banbatakumi/BLDC/ProgramV4/docs/FOC解説.pdf

## BLDC ベクトル制御 (FOC) の仕組み

ProgramV4 制御ソフトウェア解説

本資料は本プロジェクト (src/bldc/foc.c/h, bldc.c/h) が実装している FOC (Field Oriented Control) の中身を、数式と実装の対応関係込みで説明する。 対象はセンサ付き (エンコーダ 有り) の表面磁石型 (SPM) BLDC モータで、 弱め界磁は行わない (i

∗
d = 0 固定)。

### 1 全体構成

制御は 20 kHz の電流ループを中心に、そこから分周した 1 kHz の外側ループ (速度/位置) を 重ねる二重ループ構成である。

周波数 | 処理 | 内容
20 kHz | 角度観測 | エンコーダ角 → 機械角 θm・角速度 ωˆ (2次PLL)
20 kHz | 電流ループ | 電流計測 → Clarke → Park → 電流 PI → 逆Park
| | → SVPWM
1 kHz | 外側ループ | 速度 PID / 位置 PID → q 軸電流指令 i

∗
| | q

電流ループは PWM (TIM1) に同期した ADC 変換完了割り込みでそのまま駆動されるため、 サンプリング周期は PWM 周期と一致し Ts = 1/20000 s = 50 µs である。

図 1 に制御全体のブロック線図を示す。内側から順に 「電流ループ (実線)」「電気角 θe の供 給 (破線, 2次PLL観測器由来)」 「外側の速度/位置ループ (太線)」の3つのフィードバックが 重なっている。

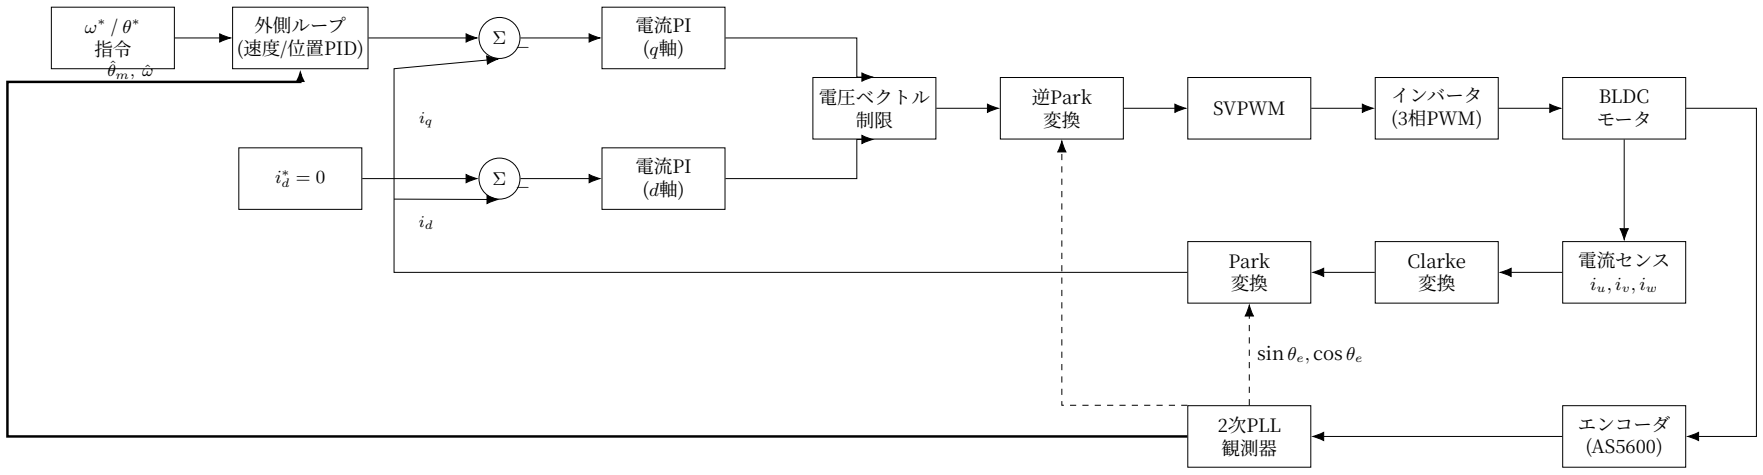
[picture p1: figure]
外側ループ; (速度/位置PID); 電流PI (q軸); 電流PI (d軸); 電圧ベクトル 制限; 逆Park; SVPWM; インバータ (3相PWM); BLDC モータ; 電流センス; Clarke 変換; Park 変換; エンコーダ (AS5600); 2次PLL 観測器; sin θe, cos θe θˆm, ωˆ

図 1: 制御ブロック線図。実線: 電流ループの信号、破線: 2次PLL観測器が供給する 電気角 θe = P ˆθm + θoffset、太線: 速度/位置フィードバック
(ˆθm, ωˆ)。

2

### 2 座標変換

3相電流 iu, iv, iw (iu + iv + iw = 0) を、モータと同期回転する d‑q 座標に移すまでの手順。

### 2.1 Clarke 変換 (振幅一定型)

3相 → 静止2軸 (α, β)。

iα = iu | (1)

iβ =

1
√
3

(iv − iw) = 1
√
3
(iu + 2iv) | (2)

2行目は iw = −(iu + iv) を代入して iv の実測だけで求めたもの（実装では iv − iw ではなくこ の形を使用）。

### 2.2 Park 変換

静止座標 → 回転座標。電気角 θe を使う。

id = iα cos θe + iβ sin θe | (3)
iq = −iα sin θe + iβ cos θe | (4)

電気角は機械角にモータの極対数 P (P = 7) を掛けて作る。

θe = P · θm + θoffset | (5)

θoffset はエンコーダ校正で決める定数で、通常 0 になるように校正する (「電気角の合わせ方」 の節を参照)。

### 2.3 逆 Park 変換

電流 PI の出力電圧 vd, vq を静止座標へ戻す。

vα = vd cos θe − vq sin θe | (6)
vβ = vd sin θe + vq cos θe | (7)

### 3 電流制御

d 軸・q 軸それぞれに独立な PI 制御器を持つ (微分項なし)。

vd = Kp (i

∗
d − id) + Ki

∫
(i

∗
d − id) dt | (8)

vq = Kp (i

∗
q − iq) + Ki

∫
(i

∗
q − iq) dt | (9)

SPM モータなので弱め界磁を行わず i

∗
d = 0 に固定する。トルク電流指令は 外側ループが決め た i

∗
q をそのまま使う。

### 3.1 ゲインの設計

モータの相インダクタンス L、相抵抗 R から、目標帯域 fbw を1次遅れとして 配置するゲイン は次式になる。

Kp = L · 2πfbw | [V/A] | (10)
Ki = R · 2πfbw | [V/(A · s)] | (11)

fbw の上限の目安は PWM 周波数の 1/10 ∼ 1/20 (20 kHz なら 1～2 kHz)。 本プロジェクトの 実装値は Kp = 0.75 V/A, Ki = 750 V/(A·s) (CURRENT_PI_KP / CURRENT_PI_KI)。

### 3.2 電圧ベクトルの円制限とアンチワインドアップ

インバータが出せる相電圧振幅には上限 vmax (母線電圧と変調方式で決まる) があるため、 (vd, vq) のベクトルの大きさをその円内に制限する。

|⃗v| =

√
v

2
d + v
| 2 q | (12)
if |⃗v| > vmax : | vd ← vd ·
| vmax
|⃗v|

, vq ← vq ·

vmax
|⃗v|
| | (13)

制限をかけたときは、そのときの縮小率を積分項にも同じ比率で掛けて縮める。 そうしない と制限中も積分器だけが指令を積み増し続け (ワインドアップ)、 制限が外れた瞬間に電流が 飛び出す。

### 4 SVPWM (空間ベクトル変調)

逆 Clarke 変換で相電圧指令をつくり、3相の最大値と最小値の中点を 全相から引く「min‑max 方式」(三次高調波重畳) でデューティを決める。

vu = vα | (14)

vv = −
1/2 vα +

√
3
2
vβ | (15)

vw = −

1/2 vα −

√
3
2
vβ | (16)

vcom =

1/2(max(vu, vv, vw) + min(vu, vv, vw)) | (17)

dx = 0.5 +

vx − vcom

Vdc

(x = u, v, w) | (18)

単純な正弦波変調に比べ、線間電圧を変えずに相電圧のピークを下げられるため、 母線電圧 の利用率が 2/√
3 ≈ 1.155 倍 (+15%) になる。

本基板はローサイドシャント電流検出のため、ADC サンプリング点で低電位側 FET が ON に なっている必要があり、デューティ上限を MAX_DUTY = 0.80 に制限している。 このとき出せる 相電圧振幅は

(0.80 − 0.5) ×

2
√
3
≈ 0.346 Vdc | (19)

まで（変調方式の理論上限は 0.577 Vdc）。この値が MAX_MODULATION_RATIO であり、 上の vmax = Vdc × MAX_MODULATION_RATIO として電流ループの円制限に使われる。

### 5 角度・速度推定 (2次PLL観測器)

角速度は「角度を微分」せず、推定角 ˆθ を観測角 θmeas に 追従させる制御ループ (2次のオブ ザーバ) として求める。内部状態 ˆθ, ωˆ が角度と速度を同時に与える。

e = θmeas − ˆθ | (イノベーション) | (20)
ωˆ += KI e ∆t | | (21)
ˆθ += (ˆω + KP e) ∆t | (22)

この閉ループの伝達関数は標準的な2次系になる。

Θ( ˆ s)

Θmeas(s)

=

| KP s + KI
s
| 2 + KP s + KI | (23)

固有角周波数と減衰係数は

ωn =

√
KI , ζ =

KP
2

√
KI

(24)

本実装は臨界制動 ζ = 1 を狙い、ωn = PLL_OMEGA_N = 250 rad/s から次のように逆算してゲ インを決めている。

KP = 2 ωn, KI = ω

2
n

(25)

微分ではなく積分で速度を作るため、(1) 量子化ノイズを増幅しない、(2) 等速回転で定常誤差 ゼロ、(3) 観測が一時的に欠測しても ωˆ による外挿で角度を進め続けられる、 という3つの性 質が同時に得られる。

### 5.1 観測値の棄却とゲート

エンコーダ (AS5600 アナログ出力) はレール付近で飽和し、角度が読めない 「盲点」区間を 持つ。信頼できない観測をそのままイノベーション e に使うと 推定が乱れるため、2種類の条 件で棄却する。

(a) 飽和: 生の ADC 値がレール付近 ⇒ 角度情報が無いと確実に分かる。 最大 ENCODER_REJECT_MAX サンプル (50 ms) まで e = 0 として外挿する。

(b) イノベーション過大: |e| が閾値 ENCODER_INNOVATION_LIMIT_RAD を超える。0/2π 継ぎ目の グリッチの可能性があるため、まず ENCODER_GLITCH_MAX サンプル (1 ms) だけ e = 0 とし て様子を見る。 それでも続く場合はグリッチではなく推定が本当にずれた（例:ロータの急 停止）と判断し、 棄却をやめて e を全量 PLL に通し再ロックさせる。

さらに、速度推定 (積分パス) に入れる e は「ロック中のみ」次式のように制限する。

espeed =

{
e | (再取得中)
clip(e, −elim, elim) (ロック中)

(26)

ロック中に残る小さな e は継ぎ目の校正誤差であって本物の回転ではないため、 積分に全量入 れると1回転ごとに速度がスパイクする。逆に再取得中に制限すると dωˆ/dt が頭打ちになり、 急停止からの再ロックができなくなる。

### 5.2 エンコーダのスケール補正

盲点幅を θdead、校正で得た ADC 値の範囲を [ Vmin, Vmax ] とすると、実際にカバーする機械 角は 2π − θdead であるため、 スケールは次式で求める（単純に 2π/(Vmax − Vmin) とすると角 度が引き伸ばされ、 継ぎ目で速度が段差状に跳ぶ）。

kenc =

2π − θdead

Vmax − Vmin

(27)

### 6 外側ループ

1 kHz で動く速度 PID・位置 PID の出力は電圧ではなく電流指令 (q 軸電流 [A]) であり、 その 先の電流ループに渡される。

速度制御: i

∗
q = Kp(ω

∗ − ωˆ) + Ki

∫
(ω
∗ − ωˆ) dt | (28)

位置制御: i

∗
q = Kp(θ

∗ − θm) + Ki

∫
(θ

∗ − θm) dt + Kd

d
dt(θ
∗ − θm) | (29)

速度指令には最大角加速度によるスルーレート制限を、位置制御には目標近傍での 不感帯 (デ ッドバンド) と積分停止を入れて、整定時の余計な電流出力を防いでいる。

### 7 保護

相電流の生値 (フィルタ前) が OVERCURRENT_LIMIT を連続 OVERCURRENT_TRIP_COUNT 回超える と出力を止めてラッチする。 また、停止時 (enable=false) は全相デューティを 0.5 にする短 絡制動ではなく、 上下 FET を両方 OFF にするコースト状態にしている。回転中の全相デュ ーティ 0.5 は 逆起電力による短絡電流

I ≈

E
|R + jωeL|

(30)

を流してしまうため、保護直後に一番電流を流したくない場面で電流が流れる、 という事故 を避けるための設計になっている。

### 8 実装ファイルとの対応

ファイル | 内容
foc.c/h | Clarke / Park / 逆Park / SVPWM / 電流 PI・円制限
| の数学部分
bldc.c/h | 角度追従オブザーバ・外側ループ・電流ループの本
| 体、保護、シリアル用の状態取得 API
current_sense.c/h | PWM 同期のローサイドシャント電流計測
app/config.h | 全パラメータ（本資料の数式中の記号との対応は表
| 中コードで参照）
