banbatakumi/BLDC/CurcuitV4/pcb.dxf

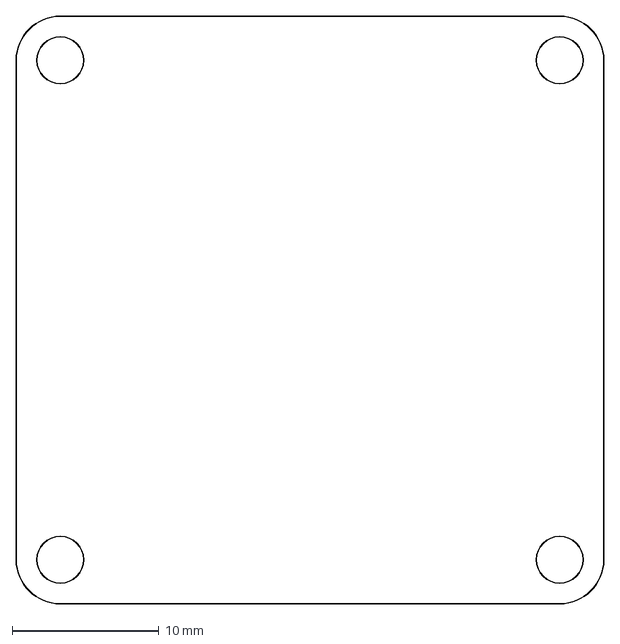
[picture p2: CAD file, 2025-06-25]
CurcuitV4/pcb.dxf
40.0 x 40.0 mm
