banbatakumi/BLDC/CurcuitV1/CurcuitV1.step

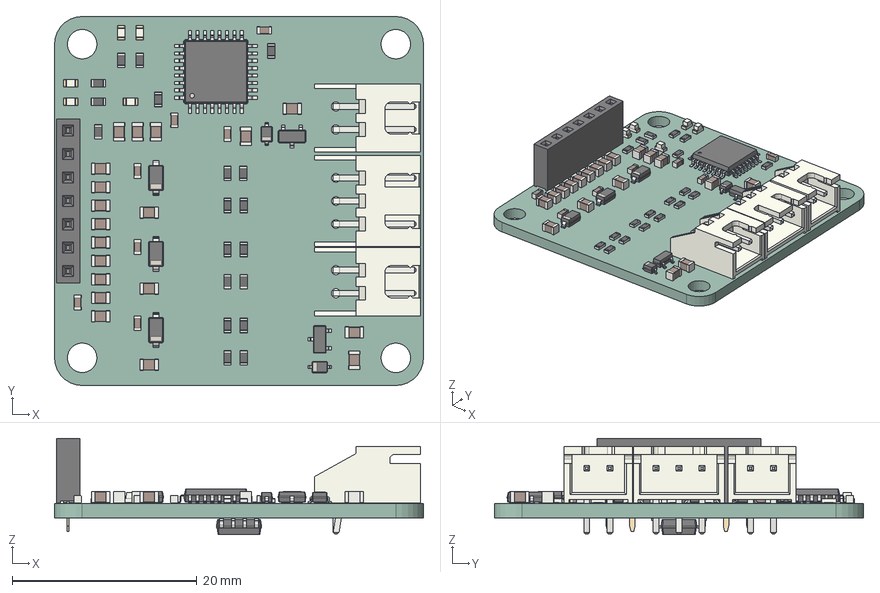
[picture p3: CAD file, 2025-06-25, an earlier design]
CurcuitV1/CurcuitV1.step
40.0 x 40.0 x 10.5 mm
D_SOD_123 x 3
R_0603_1608Metric x 19
C_0805_2012Metric x 19
PinSocket_1x07_P254mm_Vertical
JST_S2B_XH_A x 2
D_SOD_323 x 2
C_0603_1608Metric x 7
JST_S3B_XH_A
LED_0603_1608Metric x 5
LQFP_32_7x7mm_P08mm
SOT_23 x 2
SOIC_8_39x49mm_P127mm
CurcuitV1_PCB
