banbatakumi/BLDC/CurcuitV2/CurcuitV2.step

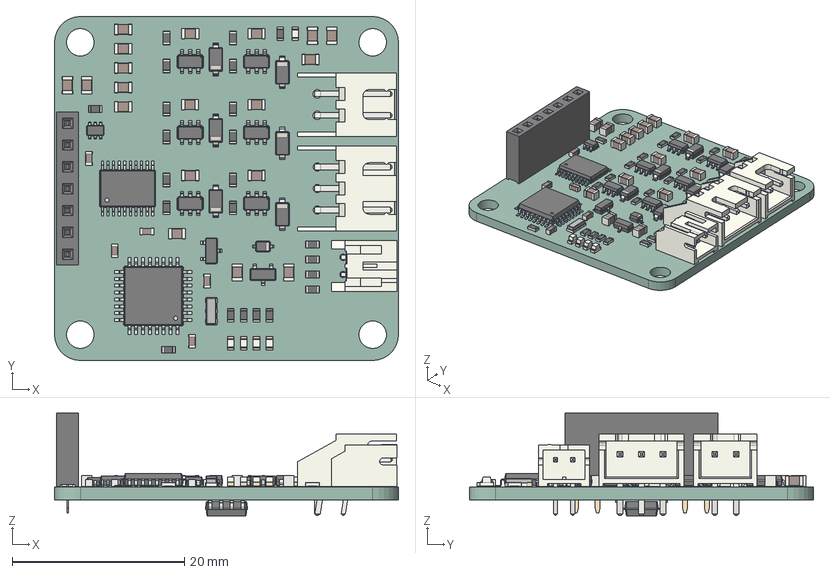
[picture p4: CAD file, 2025-07-08, an earlier design]
CurcuitV2/CurcuitV2.step
40.0 x 40.0 x 11.9 mm
TSOP-6_1.65x3.05mm_P0.95mm x 6
R_0603_1608Metric x 23
D_SOD-123 x 6
JST_PH_S2B-PH-K_1x02_P2.00mm_Horizontal
LED_0603_1608Metric x 5
LQFP-32_7x7mm_P0.8mm
C_0805_2012Metric x 19
JST_XH_S3B-XH-A_1x03_P2.50mm_Horizontal
C_0603_1608Metric x 5
D_SOD-323
PinSocket_1x07_P2.54mm_Vertical
JST_XH_S2B-XH-A_1x02_P2.50mm_Horizontal
SOT-363_SC-70-6
TSSOP-20_4.4x6.5mm_P0.65mm
SOT-23 x 2
Resonator_SMD_Murata_CSTxExxV-3Pin_3.0x1.1mm
SOIC-8_3.9x4.9mm_P1.27mm
CurcuitV2_PCB
