banbatakumi/BLDC/CurcuitV3/CurcuitV3.step

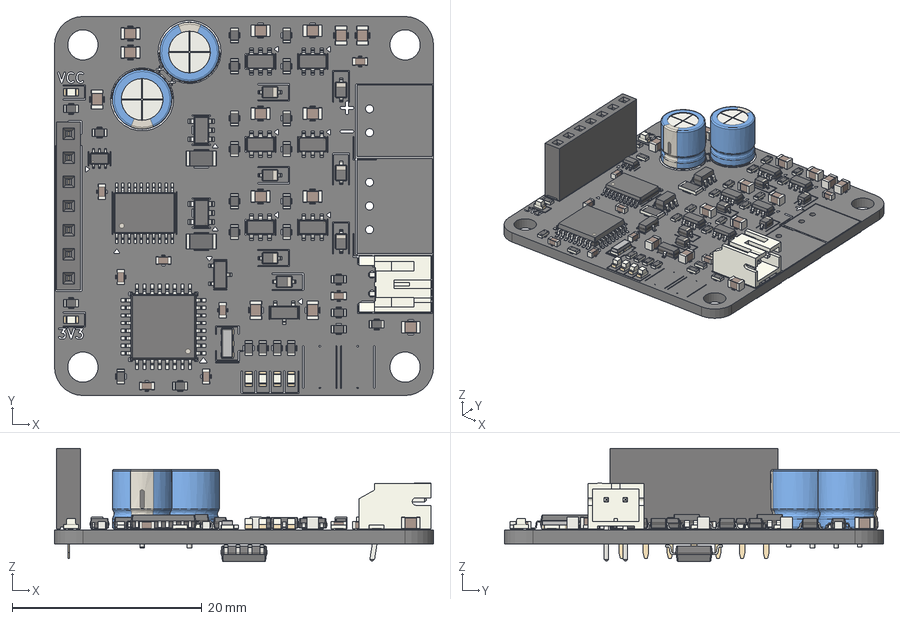
[picture p5: CAD file, 2026-06-03, an earlier design]
CurcuitV3/CurcuitV3.step
40.0 x 40.0 x 11.9 mm
TSOP-6_1.65x3.05mm_P0.95mm x 6
R_0603_1608Metric x 25
C_0603_1608Metric x 8
LED_0603_1608Metric x 6
D_SOD-323 x 7
LQFP-32_7x7mm_P0.8mm
C_0805_2012Metric x 14
Resonator_SMD_Murata_CSTxExxV-3Pin_3.0x1.1mm
CP_Radial_D6.3mm_P2.50mm x 2
JST_PH_S2B-PH-K_1x02_P2.00mm_Horizontal
PinSocket_1x07_P2.54mm_Vertical
SOT-23-5 x 2
SOT-363_SC-70-6
R_1206_3216Metric x 2
TSSOP-20_4.4x6.5mm_P0.65mm
SOT-23 x 2
SOIC-8_3.9x4.9mm_P1.27mm
CurcuitV3_silkscreen x 2
CurcuitV3_PCB
