banbatakumi/BLDC/CurcuitV4/CurcuitV4.kicad_pcb

## KiCad design CurcuitV4/CurcuitV4.kicad_pcb (2026-07-28)

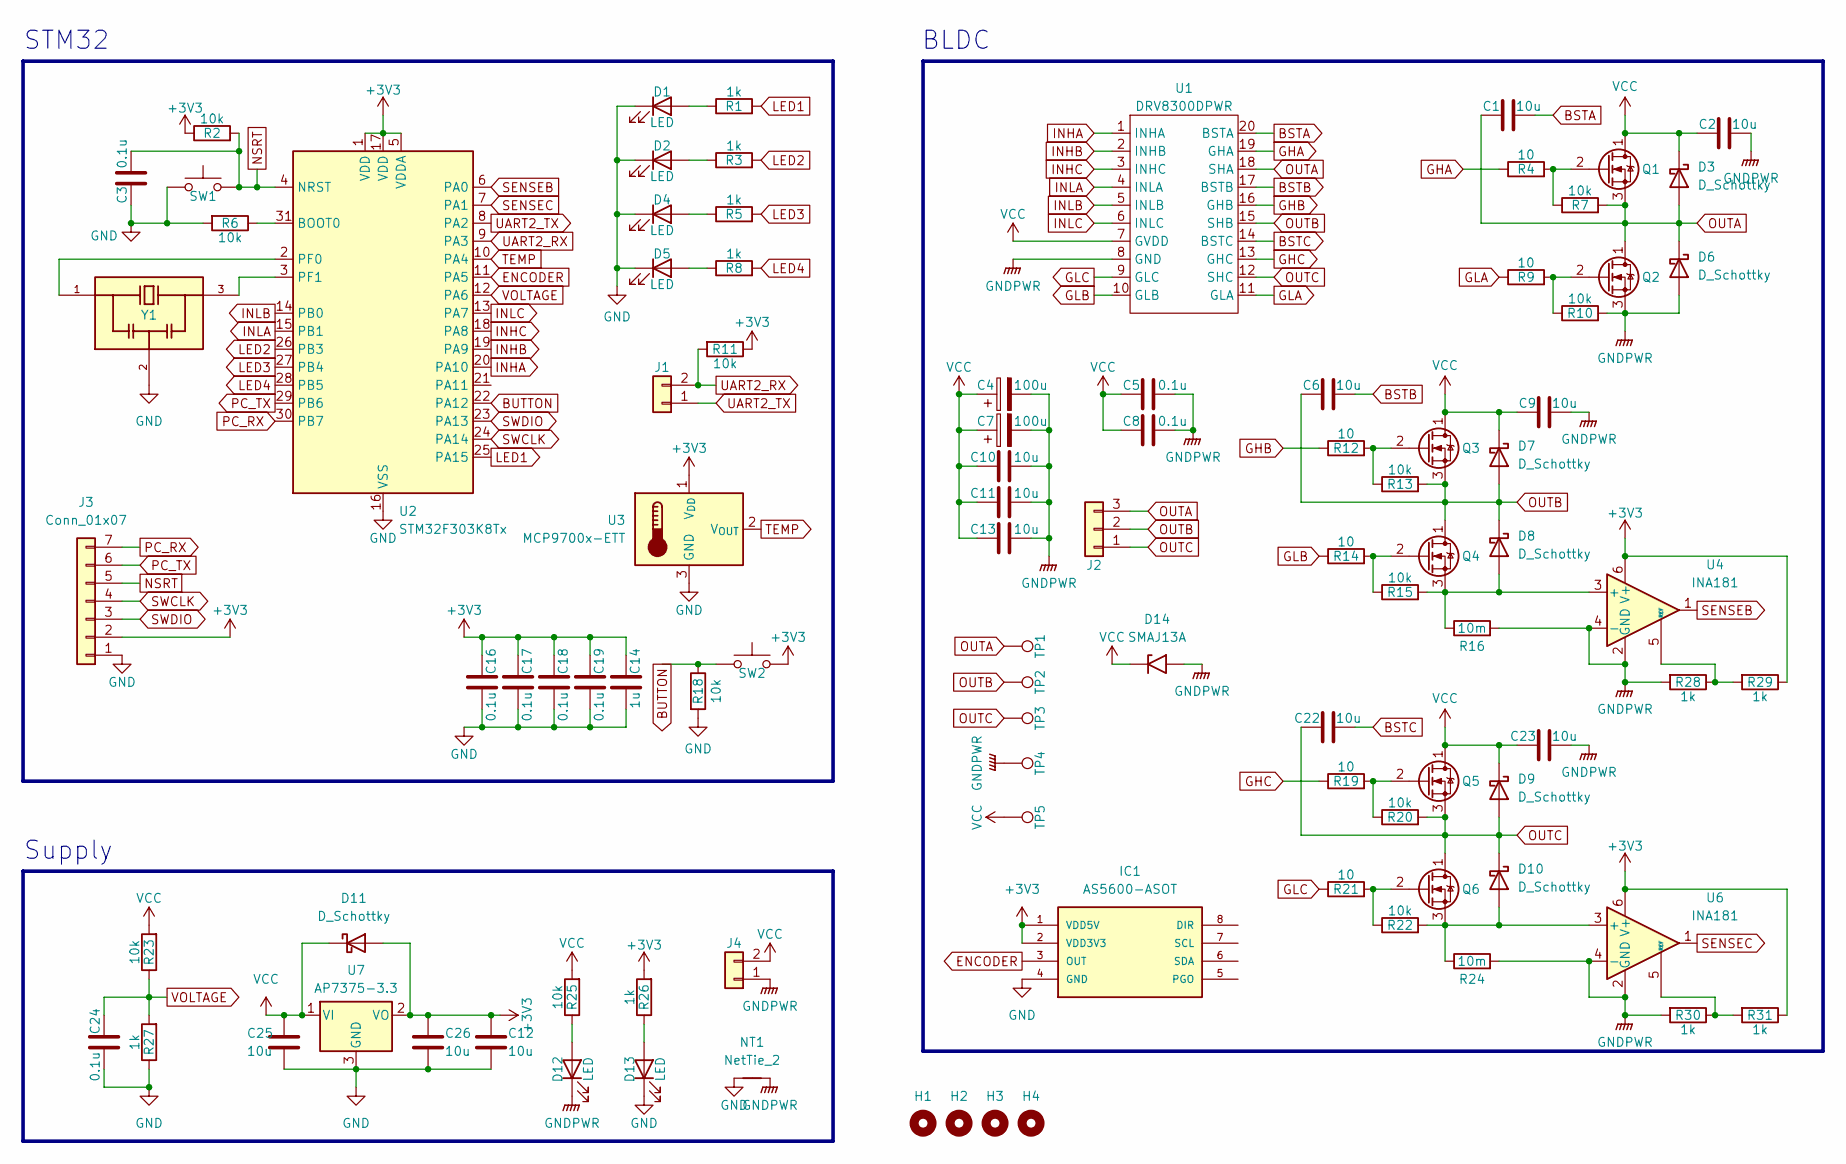
[picture p6: schematic CurcuitV4.kicad_sch]

Parts:
C1, C2, C6, C9, C10, C11, C12, C13, C22, C23, C25, C26: 10u; C_0805_2012Metric
C3, C5, C8, C16, C17, C18, C19, C24: 0.1u; C_0603_1608Metric
C4, C7: 100u; CP_Radial_D6.3mm_P2.50mm
C14: 1u; C_0603_1608Metric
D1, D2, D4, D5, D12, D13: LED; LED_0603_1608Metric
D3, D6, D7, D8, D9, D10, D11: D_Schottky; D_SOD-323_HandSoldering
D14: SMAJ13A; D_SMA
H1, H2, H3, H4: MountingHole; MountingHole_3.2mm_M3_ISO14580_Pad_TopBottom
IC1: AS5600-ASOT; SOIC-8_3.9x4.9mm_P1.27mm; MOUSER_PART_NUMBER 985-AS5600-ASOT
J1: Conn_01x02; JST_PH_S2B-PH-K_1x02_P2.00mm_Horizontal
J2: Conn_01x03; Molex_SPOX_5268-03A_1x03_P2.50mm_Horizontal
J3: Conn_01x07; PinSocket_1x07_P2.54mm_Vertical
J4: Conn_01x02; Molex_SPOX_5268-02A_1x02_P2.50mm_Horizontal
NT1: NetTie_2; NetTie-2_SMD_Pad0.5mm
Q1, Q2, Q3, Q4, Q5, Q6: Q_NMOS_DGS; SSM6K819R
R1, R3, R5, R8, R26, R27, R28, R29, R30, R31: 1k; R_0603_1608Metric
R2, R6, R7, R10, R11, R13, R15, R18, R20, R22, R23, R25: 10k; R_0603_1608Metric
R4, R9, R12, R14, R19, R21: 10; R_0603_1608Metric
R16, R24: 10m; R_1206_3216Metric
SW1, SW2: SW_Push; SW_Push_1P1T_NO_Vertical_Wuerth_434133025816
TP1, TP2, TP3, TP4, TP5: TestPoint; TestPoint_Pad_D2.5mm
U1: DRV8300DPWR; TSSOP-20_4.4x6.5mm_P0.65mm
U2: STM32F303K8Tx; LQFP-32_7x7mm_P0.8mm
U3: MCP9700x-ETT; SOT-23
U4, U6: INA181; SOT-23-6
U7: AP7375-3.3; SOT-23
Y1: CSTNE16M0V530000R0; Resonator_SMD_Murata_CSTxExxV-3Pin_3.0x1.1mm; PARTREV JGC42-8853B

Connections:
+3V3: C12.1, C14.2, C16.2, C17.2, C18.2, C19.2, C26.1, D11.2 (A), IC1.1 (VDD5V), IC1.2 (VDD3V3), J3.2, R2.1, R11.1, R26.2, R29.1, R31.1, SW2.2, U2.1 (VDD), U2.5 (VDDA), U2.17 (VDD), U3.1 (V_{DD}), U4.6 (V+), U6.6 (V+), U7.2 (VO)
BSTA: C1.2, U1.20 (BSTA)
BSTB: C6.2, U1.17 (BSTB)
BSTC: C22.2, U1.14 (BSTC)
BUTTON: R18.1, SW2.1, U2.22 (PA12)
ENCODER: IC1.3 (OUT), U2.11 (PA5)
GHA: R4.1, U1.19 (GHA)
GHB: R12.1, U1.16 (GHB)
GHC: R19.1, U1.13 (GHC)
GLA: R9.1, U1.11 (GLA)
GLB: R14.1, U1.10 (GLB)
GLC: R21.1, U1.9 (GLC)
GND: C3.2, C12.2, C14.1, C16.1, C17.1, C18.1, C19.1, C24.1, C25.2, C26.2, D1.1 (K), D2.1 (K), D4.1 (K), D5.1 (K), D13.1 (K), IC1.4 (GND), J3.1, NT1.1, R6.2, R18.2, R27.1, SW1.1, U2.16 (VSS), U2.32 (VSS), U3.3 (GND), U7.3 (GND), Y1.2
GNDPWR: C2.2, C4.2, C5.1, C7.2, C8.1, C9.2, C10.1, C11.1, C13.1, C23.2, D6.2 (A), D12.1 (K), D14.2 (A2), J4.1, NT1.2, Q2.3 (S), R10.2, R16.2, R24.2, R28.2, R30.2, TP4.1, U1.8 (GND), U4.2 (GND), U4.4 (-), U6.2 (GND), U6.4 (-)
INHA: U1.1 (INHA), U2.20 (PA10)
INHB: U1.2 (INHB), U2.19 (PA9)
INHC: U1.3 (INHC), U2.18 (PA8)
INLA: U1.4 (INLA), U2.15 (PB1)
INLB: U1.5 (INLB), U2.14 (PB0)
INLC: U1.6 (INLC), U2.13 (PA7)
LED1: R1.2, U2.25 (PA15)
LED2: R3.2, U2.26 (PB3)
LED3: R5.2, U2.27 (PB4)
LED4: R8.2, U2.28 (PB5)
NSRT: C3.1, J3.5, R2.2, SW1.2, U2.4 (NRST)
unnamed: D1.2 (A), R1.1
unnamed: D2.2 (A), R3.1
unnamed: D4.2 (A), R5.1
unnamed: D5.2 (A), R8.1
unnamed: D8.2 (A), Q4.3 (S), R15.2, R16.1, U4.3 (+)
unnamed: D10.2 (A), Q6.3 (S), R22.2, R24.1, U6.3 (+)
unnamed: D12.2 (A), R25.1
unnamed: D13.2 (A), R26.1
unnamed: Q1.2 (G), R4.2, R7.1
unnamed: Q2.2 (G), R9.2, R10.1
unnamed: Q3.2 (G), R12.2, R13.1
unnamed: Q4.2 (G), R14.2, R15.1
unnamed: Q5.2 (G), R19.2, R20.1
unnamed: Q6.2 (G), R21.2, R22.1
unnamed: R6.1, U2.31 (BOOT0)
unnamed: U2.2 (PF0), Y1.1
unnamed: U2.3 (PF1), Y1.3
unnamed: R28.1, R29.2, U4.5 (REF)
unnamed: R30.1, R31.2, U6.5 (REF)
OUTA: C1.1, D3.2 (A), D6.1 (K), J2.3, Q1.3 (S), Q2.1 (D), R7.2, TP1.1, U1.18 (SHA)
OUTB: C6.1, D7.2 (A), D8.1 (K), J2.2, Q3.3 (S), Q4.1 (D), R13.2, TP2.1, U1.15 (SHB)
OUTC: C22.1, D9.2 (A), D10.1 (K), J2.1, Q5.3 (S), Q6.1 (D), R20.2, TP3.1, U1.12 (SHC)
PC_RX: J3.7, U2.30 (PB7)
PC_TX: J3.6, U2.29 (PB6)
SENSEB: U2.6 (PA0), U4.1
SENSEC: U2.7 (PA1), U6.1
SWCLK: J3.4, U2.24 (PA14)
SWDIO: J3.3, U2.23 (PA13)
TEMP: U2.10 (PA4), U3.2 (V_{OUT})
UART2_RX: J1.2, R11.2, U2.9 (PA3)
UART2_TX: J1.1, U2.8 (PA2)
VCC: C2.1, C4.1, C5.2, C7.1, C8.2, C9.1, C10.2, C11.2, C13.2, C23.1, C25.1, D3.1 (K), D7.1 (K), D9.1 (K), D11.1 (K), D14.1 (A1), J4.2, Q1.1 (D), Q3.1 (D), Q5.1 (D), R23.2, R25.2, TP5.1, U1.7 (GVDD), U7.1 (VI)
VOLTAGE: C24.2, R23.1, R27.2, U2.12 (PA6)

Notes on the sheet:
Supply
STM32
BLDC

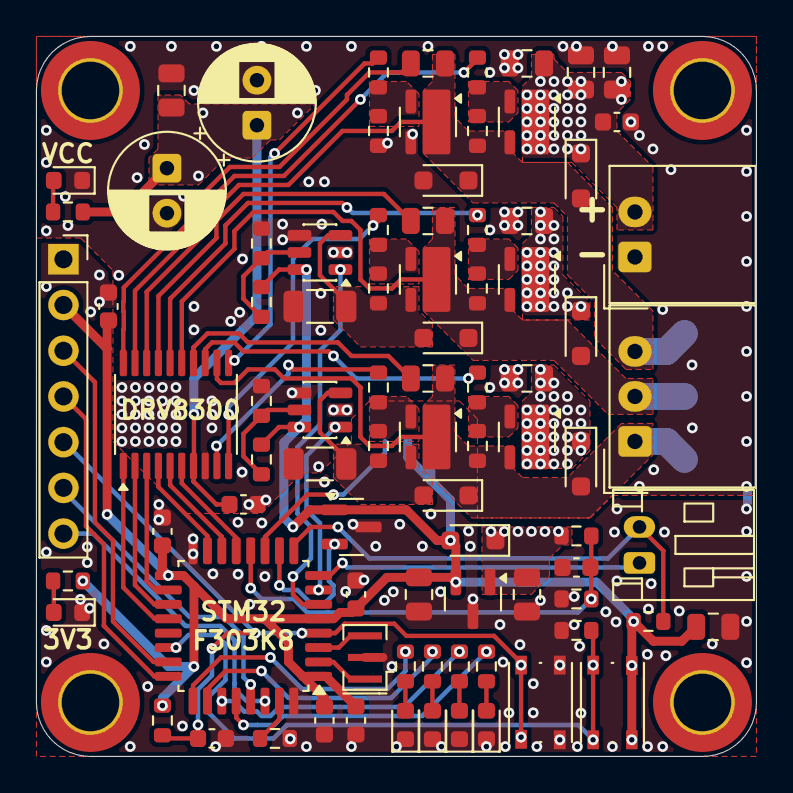
[picture p7: board CurcuitV4.kicad_pcb from above]

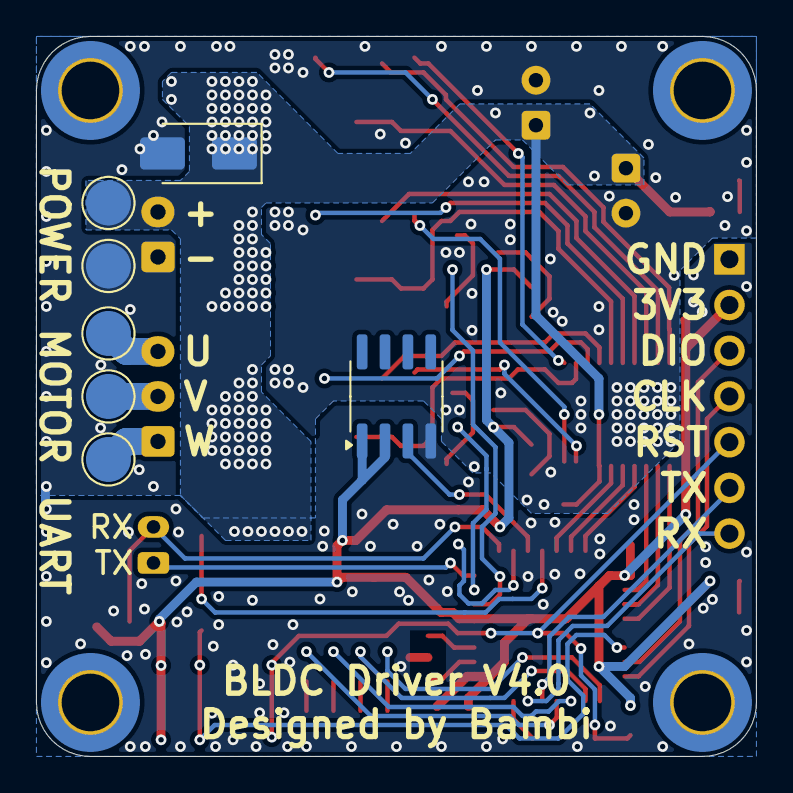
[picture p8: board CurcuitV4.kicad_pcb from below]

Board: 2 copper layers, 40.0 x 40.0 mm, 97 parts (8 on the bottom side), 58 nets.
