banbatakumi/BLDC/CurcuitV2/CurcuitV2.kicad_pcb

## KiCad design CurcuitV2/CurcuitV2.kicad_pcb (2025-07-08, an earlier design)

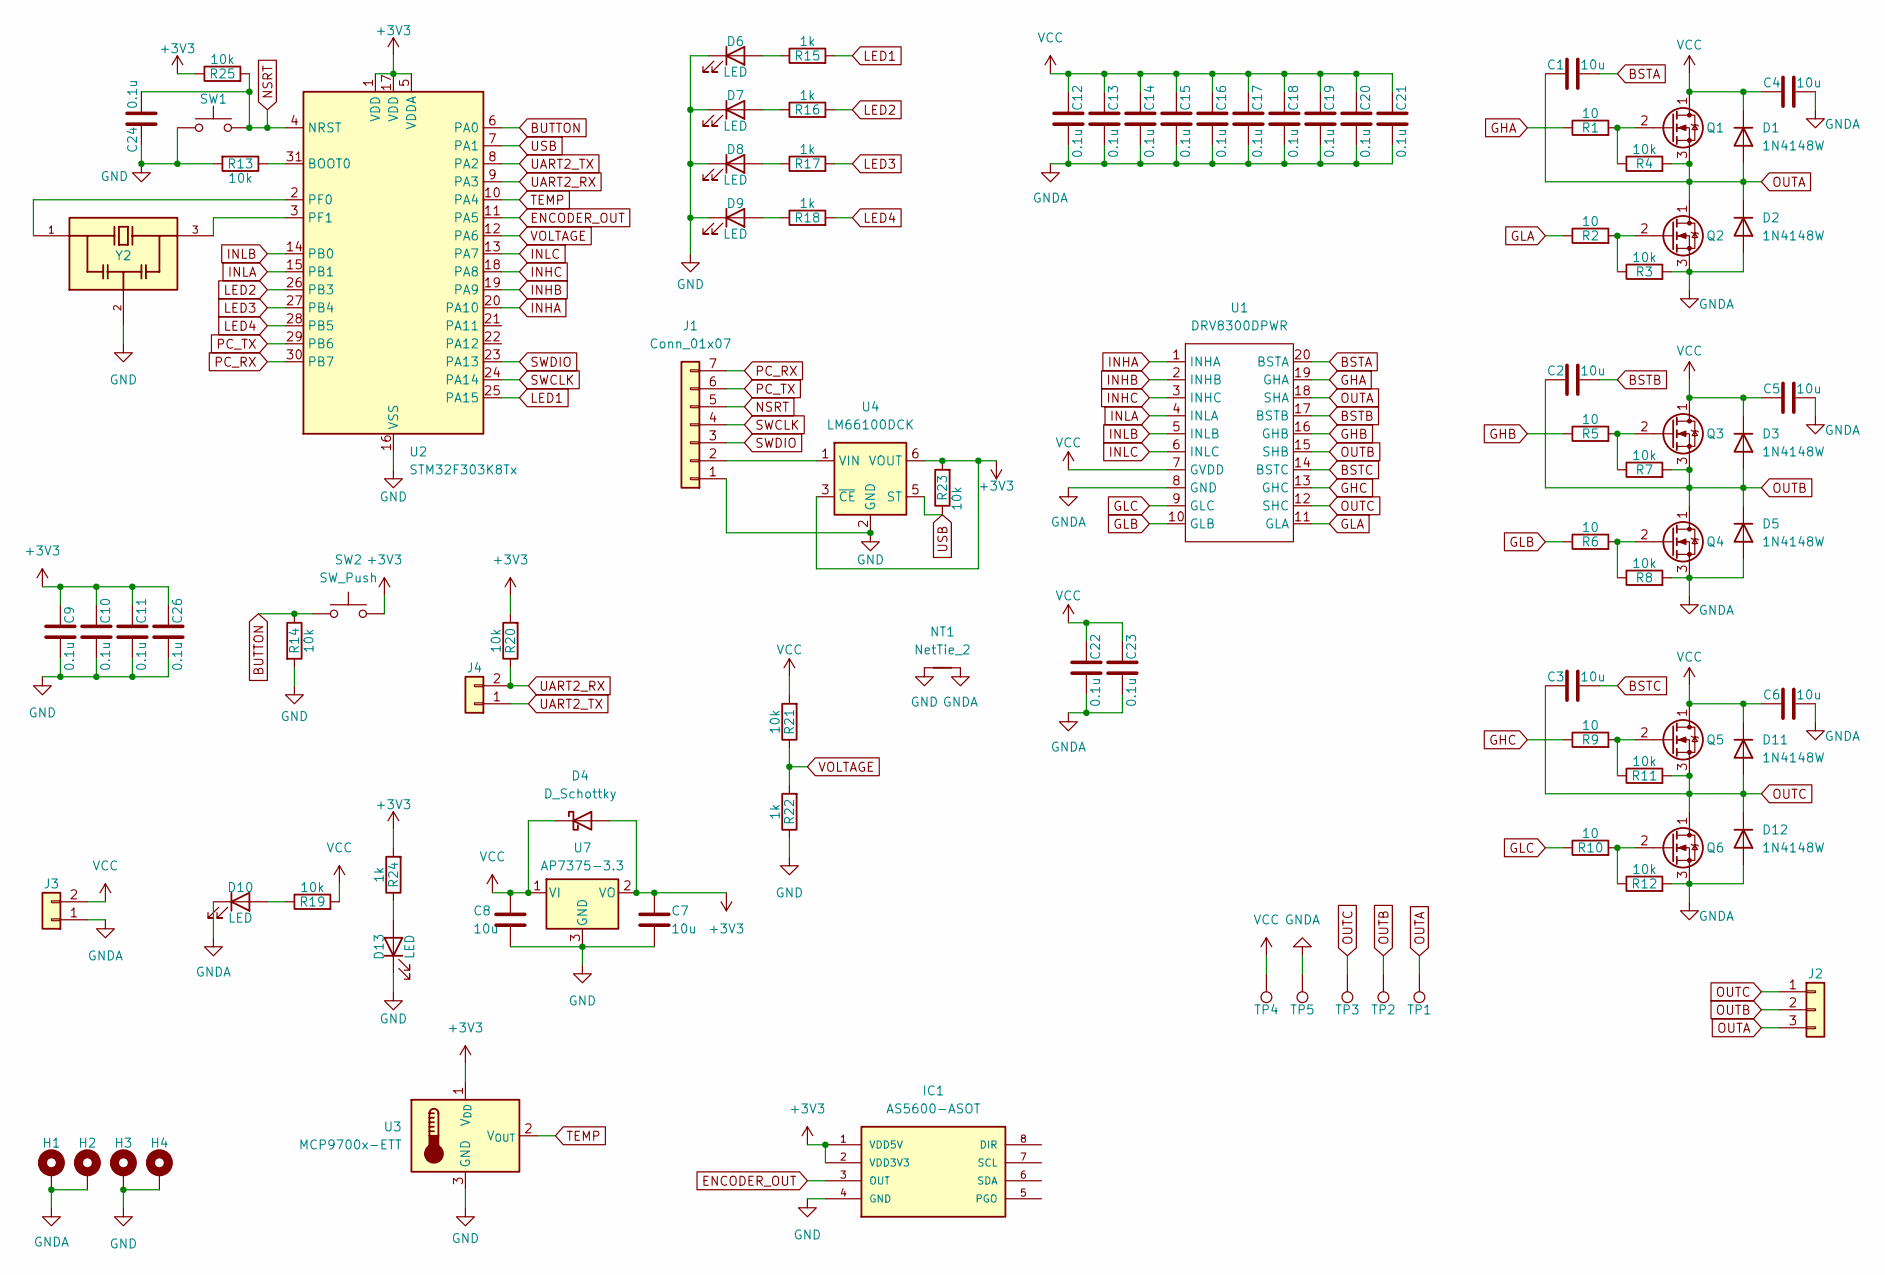
[picture p9: schematic CurcuitV2.kicad_sch]

Parts:
C1, C2, C3, C4, C5, C6, C7, C8: 10u; C_0805_2012Metric
C9, C10, C11, C22, C24, C26: 0.1u; C_0603_1608Metric
C12, C13, C14, C15, C16, C17, C18, C19, C20, C21, C23: 0.1u; C_0805_2012Metric
D1, D2, D3, D5, D11, D12: 1N4148W; D_SOD-123
D4: D_Schottky; D_SOD-323_HandSoldering
D6, D7, D8, D9, D10, D13: LED; LED_0603_1608Metric
H1, H2, H3, H4: MountingHole_Pad; MountingHole_3.2mm_M3_ISO14580_Pad_TopBottom
IC1: AS5600-ASOT; SOIC-8_3.9x4.9mm_P1.27mm; MOUSER_PART_NUMBER 985-AS5600-ASOT
J1: Conn_01x07; PinSocket_1x07_P2.54mm_Vertical
J2: Conn_01x03; JST_XH_S3B-XH-A_1x03_P2.50mm_Horizontal
J3: Conn_01x02; JST_XH_S2B-XH-A_1x02_P2.50mm_Horizontal
J4: Conn_01x02; JST_PH_S2B-PH-K_1x02_P2.00mm_Horizontal
NT1: NetTie_2; NetTie-2_SMD_Pad2.0mm
Q1, Q2, Q3, Q4, Q5, Q6: Q_NMOS_DGS; SSM6K819R
R1, R2, R5, R6, R9, R10: 10; R_0603_1608Metric
R3, R4, R7, R8, R11, R12, R13, R14, R19, R20, R21, R23, R25: 10k; R_0603_1608Metric
R15, R16, R17, R18, R22, R24: 1k; R_0603_1608Metric
SW1, SW2: SW_Push; SW_Push_1P1T_NO_Vertical_Wuerth_434133025816
TP1, TP2, TP3, TP4, TP5: TestPoint; TestPoint_Pad_D2.5mm
U1: DRV8300DPWR; TSSOP-20_4.4x6.5mm_P0.65mm
U2: STM32F303K8Tx; LQFP-32_7x7mm_P0.8mm
U3: MCP9700x-ETT; SOT-23
U4: LM66100DCK; SOT-363_SC-70-6
U7: AP7375-3.3; SOT-23
Y2: CSTNE16M0V530000R0; Resonator_SMD_Murata_CSTxExxV-3Pin_3.0x1.1mm; PARTREV JGC42-8853B

Connections:
+3V3: C7.1, C9.2, C10.2, C11.2, C26.2, D4.2 (A), IC1.1 (VDD5V), IC1.2 (VDD3V3), R20.2, R23.2, R24.2, R25.1, SW2.2, U2.1 (VDD), U2.5 (VDDA), U2.17 (VDD), U3.1 (V_{DD}), U4.3 (~CE), U4.6 (VOUT), U7.2 (VO)
BSTA: C1.2, U1.20 (BSTA)
BSTB: C2.2, U1.17 (BSTB)
BSTC: C3.2, U1.14 (BSTC)
BUTTON: R14.1, SW2.1, U2.6 (PA0)
ENCODER_OUT: IC1.3 (OUT), U2.11 (PA5)
GHA: R1.1, U1.19 (GHA)
GHB: R5.1, U1.16 (GHB)
GHC: R9.1, U1.13 (GHC)
GLA: R2.1, U1.11 (GLA)
GLB: R6.1, U1.10 (GLB)
GLC: R10.1, U1.9 (GLC)
GND: C7.2, C8.2, C9.1, C10.1, C11.1, C24.2, C26.1, D6.1 (K), D7.1 (K), D8.1 (K), D9.1 (K), D13.1 (K), H3.1, H4.1, IC1.4 (GND), J1.1, NT1.1, R13.2, R14.2, R22.1, SW1.1, U2.16 (VSS), U2.32 (VSS), U3.3 (GND), U4.2 (GND), U7.3 (GND), Y2.2
GNDA: C4.2, C5.2, C6.2, C12.1, C13.1, C14.1, C15.1, C16.1, C17.1, C18.1, C19.1, C20.1, C21.1, C22.1, C23.1, D2.2 (A), D5.2 (A), D10.1 (K), D12.2 (A), H1.1, H2.1, J3.1, NT1.2, Q2.3 (S), Q4.3 (S), Q6.3 (S), R3.2, R8.2, R12.2, TP5.1, U1.8 (GND)
INHA: U1.1 (INHA), U2.20 (PA10)
INHB: U1.2 (INHB), U2.19 (PA9)
INHC: U1.3 (INHC), U2.18 (PA8)
INLA: U1.4 (INLA), U2.15 (PB1)
INLB: U1.5 (INLB), U2.14 (PB0)
INLC: U1.6 (INLC), U2.13 (PA7)
LED1: R15.2, U2.25 (PA15)
LED2: R16.2, U2.26 (PB3)
LED3: R17.2, U2.27 (PB4)
LED4: R18.2, U2.28 (PB5)
NSRT: C24.1, J1.5, R25.2, SW1.2, U2.4 (NRST)
unnamed: D6.2 (A), R15.1
unnamed: D7.2 (A), R16.1
unnamed: D8.2 (A), R17.1
unnamed: D9.2 (A), R18.1
unnamed: D10.2 (A), R19.1
unnamed: D13.2 (A), R24.1
unnamed: J1.2, U4.1 (VIN)
unnamed: Q1.2 (G), R1.2, R4.1
unnamed: Q2.2 (G), R2.2, R3.1
unnamed: Q3.2 (G), R5.2, R7.1
unnamed: Q4.2 (G), R6.2, R8.1
unnamed: Q5.2 (G), R9.2, R11.1
unnamed: Q6.2 (G), R10.2, R12.1
unnamed: R13.1, U2.31 (BOOT0)
unnamed: U2.2 (PF0), Y2.1
unnamed: U2.3 (PF1), Y2.3
OUTA: C1.1, D1.2 (A), D2.1 (K), J2.3, Q1.3 (S), Q2.1 (D), R4.2, TP1.1, U1.18 (SHA)
OUTB: C2.1, D3.2 (A), D5.1 (K), J2.2, Q3.3 (S), Q4.1 (D), R7.2, TP2.1, U1.15 (SHB)
OUTC: C3.1, D11.2 (A), D12.1 (K), J2.1, Q5.3 (S), Q6.1 (D), R11.2, TP3.1, U1.12 (SHC)
PC_RX: J1.7, U2.30 (PB7)
PC_TX: J1.6, U2.29 (PB6)
SWCLK: J1.4, U2.24 (PA14)
SWDIO: J1.3, U2.23 (PA13)
TEMP: U2.10 (PA4), U3.2 (V_{OUT})
UART2_RX: J4.2, R20.1, U2.9 (PA3)
UART2_TX: J4.1, U2.8 (PA2)
USB: R23.1, U2.7 (PA1), U4.5 (ST)
VCC: C4.1, C5.1, C6.1, C8.1, C12.2, C13.2, C14.2, C15.2, C16.2, C17.2, C18.2, C19.2, C20.2, C21.2, C22.2, C23.2, D1.1 (K), D3.1 (K), D4.1 (K), D11.1 (K), J3.2, Q1.1 (D), Q3.1 (D), Q5.1 (D), R19.2, R21.2, TP4.1, U1.7 (GVDD), U7.1 (VI)
VOLTAGE: R21.1, R22.2, U2.12 (PA6)

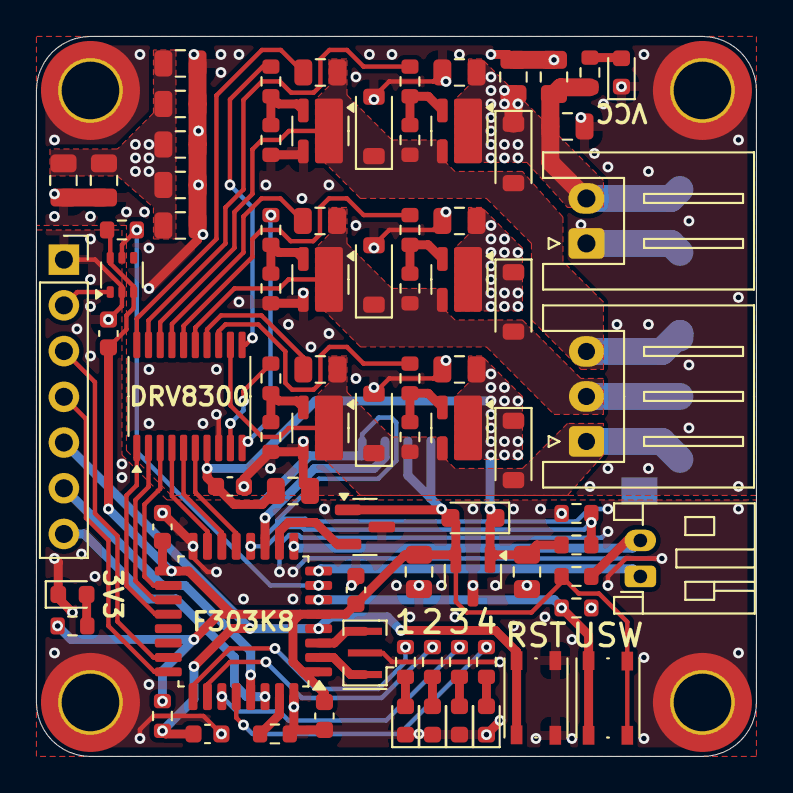
[picture p10: board CurcuitV2.kicad_pcb from above]

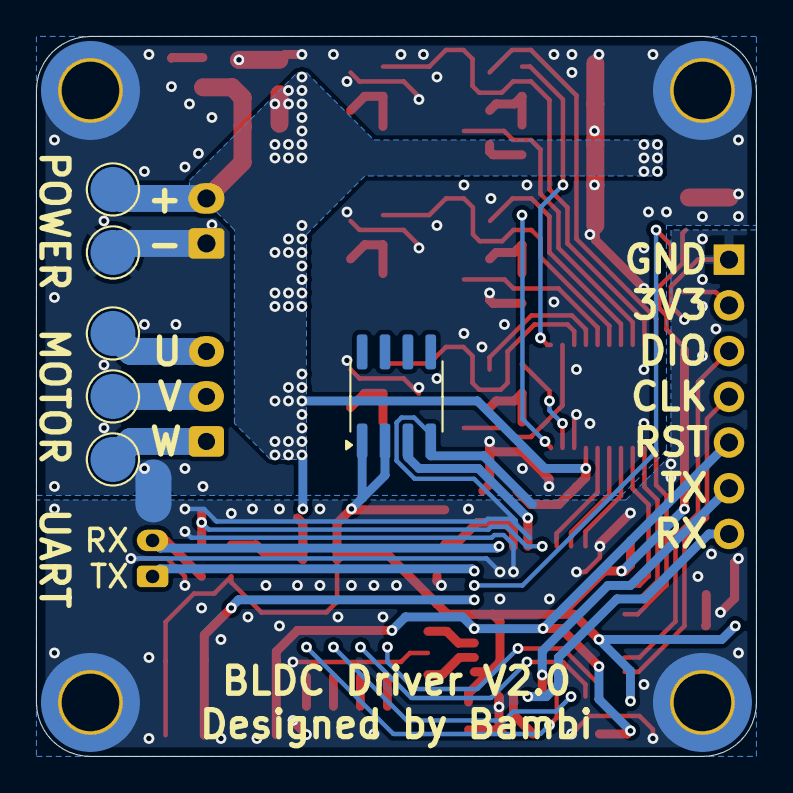
[picture p11: board CurcuitV2.kicad_pcb from below]

Board: 2 copper layers, 40.0 x 40.0 mm, 92 parts (7 on the bottom side), 54 nets.
