banbatakumi/BLDC/CurcuitV1/CurcuitV1.kicad_pcb

## KiCad design CurcuitV1/CurcuitV1.kicad_pcb (2025-06-25, an earlier design)

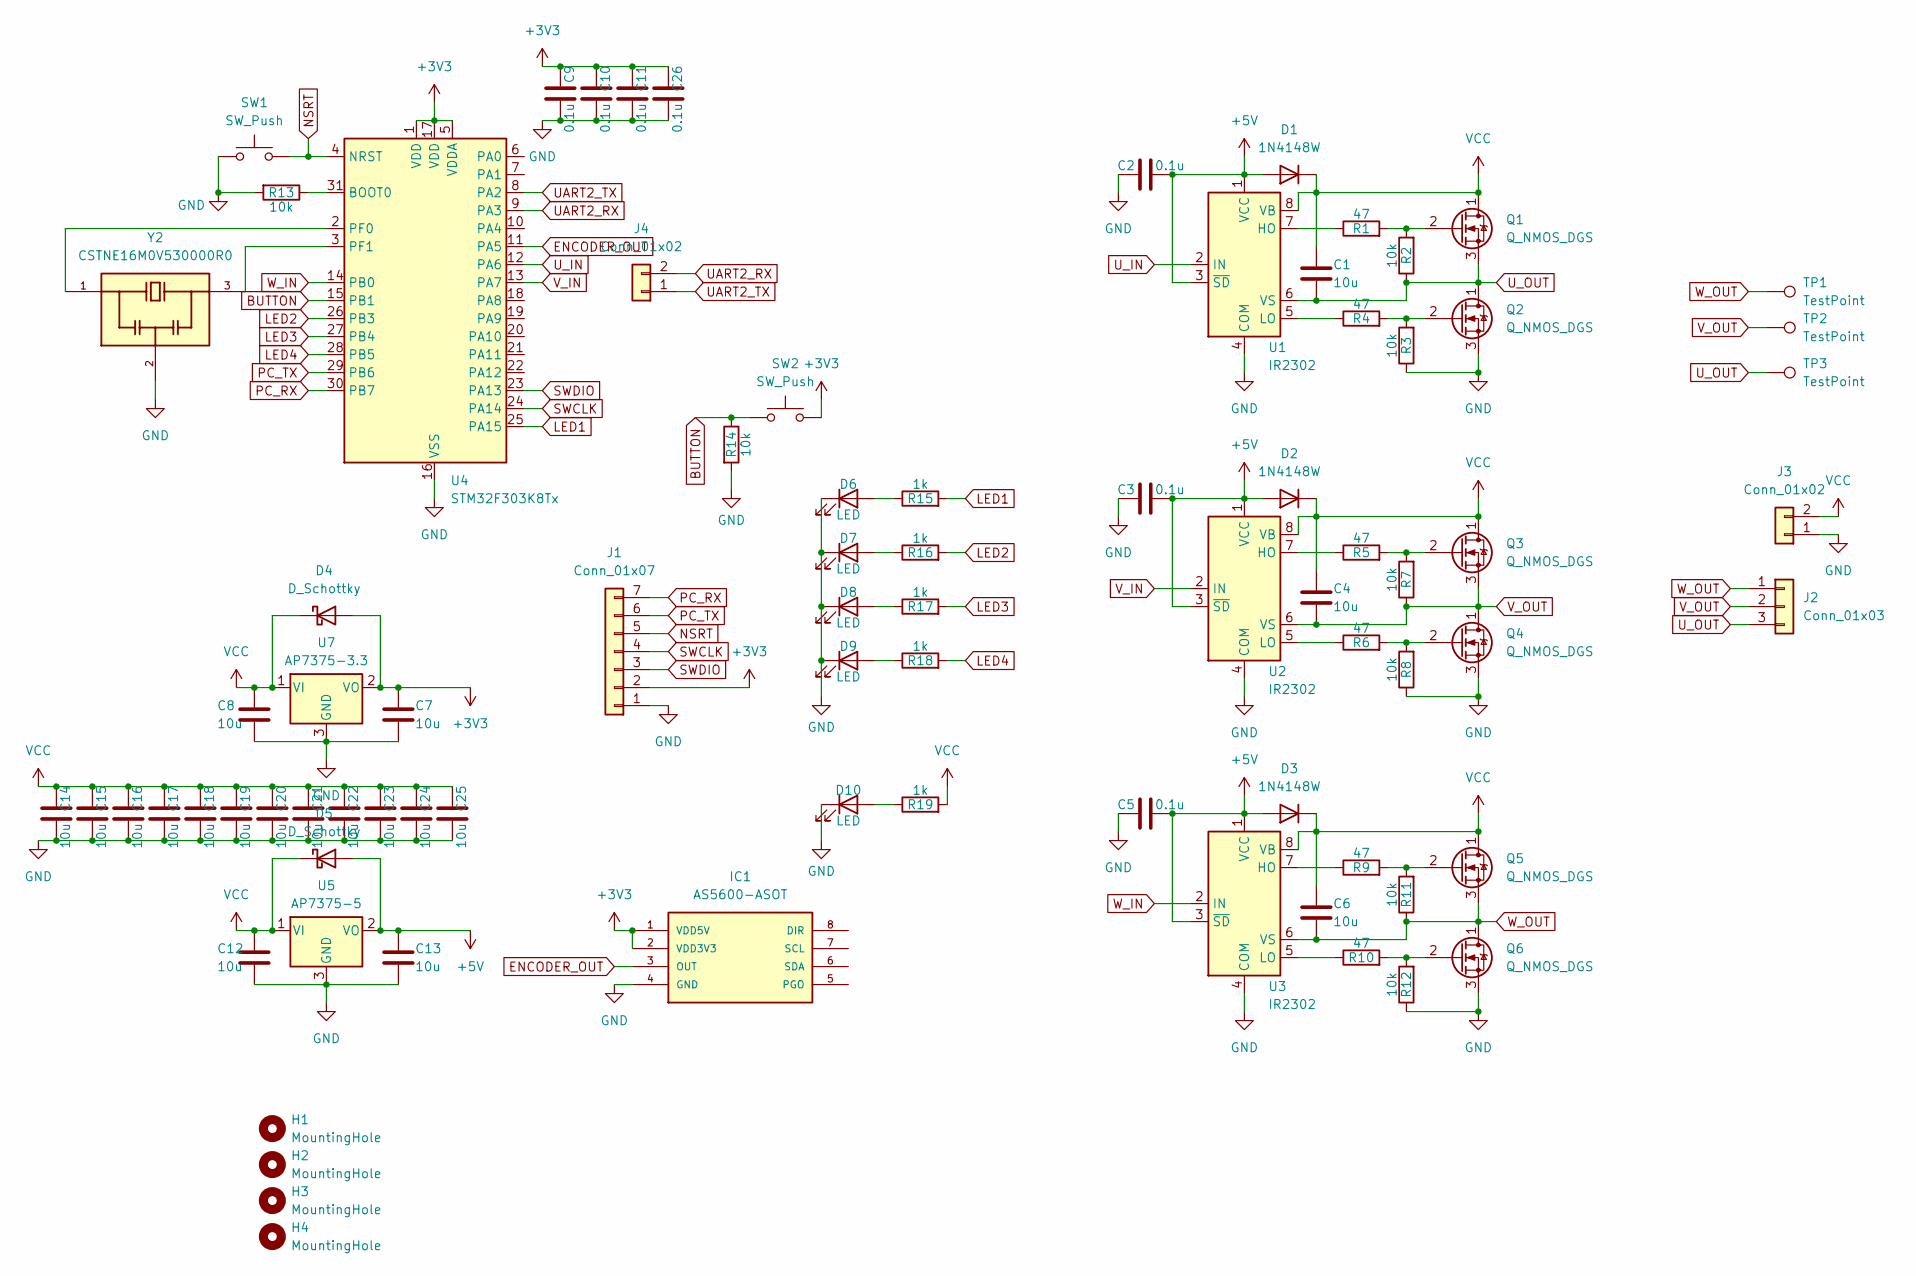
[picture p12: schematic CurcuitV1.kicad_sch]

Parts:
C1, C4, C6, C7, C8, C12, C13, C14, C15, C16, C17, C18, C19, C20, C21, C22, C23, C24, C25: 10u; C_0805_2012Metric
C2, C3, C5, C9, C10, C11, C26: 0.1u; C_0603_1608Metric
D1, D2, D3: 1N4148W; D_SOD-123
D4, D5: D_Schottky; D_SOD-323_HandSoldering
D6, D7, D8, D9, D10: LED; LED_0603_1608Metric
H1, H2, H3, H4: MountingHole; MountingHole_3.2mm_M3_DIN965_Pad
IC1: AS5600-ASOT; SOIC-8_3.9x4.9mm_P1.27mm; MOUSER_PART_NUMBER 985-AS5600-ASOT
J1: Conn_01x07; PinSocket_1x07_P2.54mm_Vertical
J2: Conn_01x03; JST_XH_S3B-XH-A_1x03_P2.50mm_Horizontal
J3, J4: Conn_01x02; JST_XH_S2B-XH-A_1x02_P2.50mm_Horizontal
Q1, Q2, Q3, Q4, Q5, Q6: Q_NMOS_DGS; SSM6K819R
R1, R4, R5, R6, R9, R10: 47; R_0603_1608Metric
R2, R3, R7, R8, R11, R12, R13, R14: 10k; R_0603_1608Metric
R15, R16, R17, R18, R19: 1k; R_0603_1608Metric
SW1, SW2: SW_Push; SW_Push_1P1T_NO_Vertical_Wuerth_434133025816
TP1, TP2, TP3: TestPoint; TestPoint_Pad_D2.0mm
U1, U2, U3: IR2302; SOP-8_3.9x4.9mm_P1.27mm
U4: STM32F303K8Tx; LQFP-32_7x7mm_P0.8mm
U5: AP7375-5; SOT-23
U7: AP7375-3.3; SOT-23
Y2: CSTNE16M0V530000R0; OSC_CSTNE16M0V530000R0; PARTREV JGC42-8853B

Connections:
+3V3: C7.1, C9.2, C10.2, C11.2, C26.2, D4.2 (A), IC1.1 (VDD5V), IC1.2 (VDD3V3), J1.2, SW2.2, U4.1 (VDD), U4.5 (VDDA), U4.17 (VDD), U7.2 (VO)
+5V: C2.1, C3.1, C5.1, C13.1, D1.2 (A), D2.2 (A), D3.2 (A), D5.2 (A), U1.1 (VCC), U1.3 (~SD), U2.1 (VCC), U2.3 (~SD), U3.1 (VCC), U3.3 (~SD), U5.2 (VO)
BUTTON: R14.1, SW2.1, U4.15 (PB1)
ENCODER_OUT: IC1.3 (OUT), U4.11 (PA5)
GND: C2.2, C3.2, C5.2, C7.2, C8.2, C9.1, C10.1, C11.1, C12.2, C13.2, C14.1, C15.1, C16.1, C17.1, C18.1, C19.1, C20.1, C21.1, C22.1, C23.1, C24.1, C25.1, C26.1, D6.1 (K), D7.1 (K), D8.1 (K), D9.1 (K), D10.1 (K), IC1.4 (GND), J1.1, J3.1, Q2.3 (S), Q4.3 (S), Q6.3 (S), R3.1, R8.1, R12.1, R13.2, R14.2, SW1.1, U1.4 (COM), U2.4 (COM), U3.4 (COM), U4.16 (VSS), U4.32 (VSS), U5.3 (GND), U7.3 (GND), Y2.2
LED1: R15.2, U4.25 (PA15)
LED2: R16.2, U4.26 (PB3)
LED3: R17.2, U4.27 (PB4)
LED4: R18.2, U4.28 (PB5)
NSRT: J1.5, SW1.2, U4.4 (NRST)
unnamed: D6.2 (A), R15.1
unnamed: D7.2 (A), R16.1
unnamed: D8.2 (A), R17.1
unnamed: D9.2 (A), R18.1
unnamed: D10.2 (A), R19.1
unnamed: Q1.2 (G), R1.2, R2.2
unnamed: Q2.2 (G), R3.2, R4.2
unnamed: Q3.2 (G), R5.2, R7.2
unnamed: Q4.2 (G), R6.2, R8.2
unnamed: Q5.2 (G), R9.2, R11.2
unnamed: Q6.2 (G), R10.2, R12.2
unnamed: R1.1, U1.7 (HO)
unnamed: R4.1, U1.5 (LO)
unnamed: R5.1, U2.7 (HO)
unnamed: R6.1, U2.5 (LO)
unnamed: R9.1, U3.7 (HO)
unnamed: R10.1, U3.5 (LO)
unnamed: R13.1, U4.31 (BOOT0)
unnamed: U4.2 (PF0), Y2.1
unnamed: U4.3 (PF1), Y2.3
PC_RX: J1.7, U4.30 (PB7)
PC_TX: J1.6, U4.29 (PB6)
SWCLK: J1.4, U4.24 (PA14)
SWDIO: J1.3, U4.23 (PA13)
UART2_RX: J4.2, U4.9 (PA3)
UART2_TX: J4.1, U4.8 (PA2)
U_IN: U1.2 (IN), U4.12 (PA6)
U_OUT: C1.2, J2.3, Q1.3 (S), Q2.1 (D), R2.1, TP3.1, U1.6 (VS)
VCC: C1.1, C4.1, C6.1, C8.1, C12.1, C14.2, C15.2, C16.2, C17.2, C18.2, C19.2, C20.2, C21.2, C22.2, C23.2, C24.2, C25.2, D1.1 (K), D2.1 (K), D3.1 (K), D4.1 (K), D5.1 (K), J3.2, Q1.1 (D), Q3.1 (D), Q5.1 (D), R19.2, U1.8 (VB), U2.8 (VB), U3.8 (VB), U5.1 (VI), U7.1 (VI)
V_IN: U2.2 (IN), U4.13 (PA7)
V_OUT: C4.2, J2.2, Q3.3 (S), Q4.1 (D), R7.1, TP2.1, U2.6 (VS)
W_IN: U3.2 (IN), U4.14 (PB0)
W_OUT: C6.2, J2.1, Q5.3 (S), Q6.1 (D), R11.1, TP1.1, U3.6 (VS)

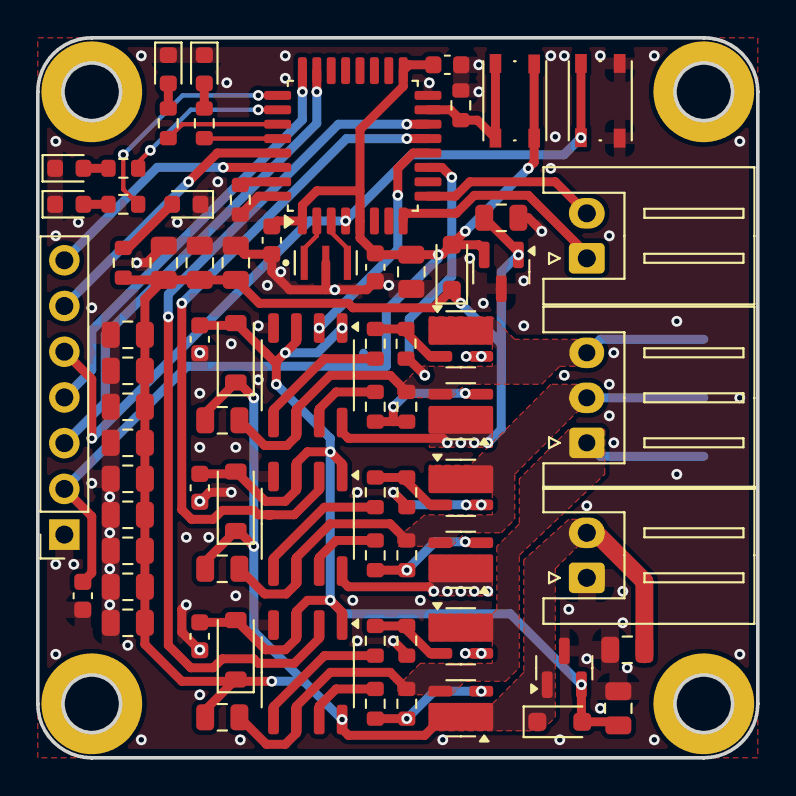
[picture p13: board CurcuitV1.kicad_pcb from above]

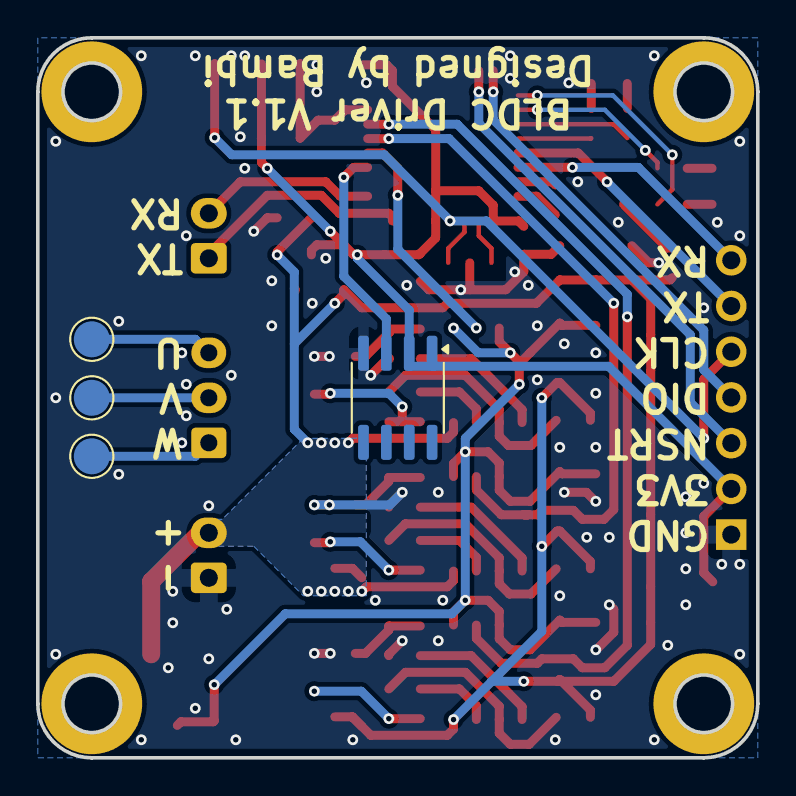
[picture p14: board CurcuitV1.kicad_pcb from below]

Board: 2 copper layers, 40.0 x 40.0 mm, 82 parts (4 on the bottom side), 43 nets.
