banbatakumi/BLDC/ProgramV4/src/app/config.h

#ifndef CONFIG_H_
#define CONFIG_H_

// ===========================================================================
// ADC (共通)
// ===========================================================================
// ADC1(相電流) も ADC2(エンコーダ・電源電圧・温度) も 12bit・基準 3.3V。
#define MAX_ADC_VAL 4095           // ADCの最大値(12bit)
#define ADC2VOLT 0.0008058608059f  // ADC値 → 電圧 [V] (3.3V / 4095)
#define SUPPLY_VOLT_DIVIDER 10.0f  // 母線電圧の分圧比 (ADC の電圧 × これ = 母線電圧)

// ===========================================================================
// 保護
// ===========================================================================
#define TEMP_LIMIT 60  // 温度制限 [°C]

#define SUPPLY_VOLTAGE_MIN_LIMIT 7
#define SUPPLY_VOLTAGE_MAX_LIMIT 15

// 電圧が範囲外のまま、この時間 [ms] 続いたときだけ停止する (一瞬の電圧降下・回生スパイク対策)。
#define SUPPLY_VOLTAGE_TRIP_DELAY_MS 500

// 停止後の復帰ヒステリシス [V]。範囲の内側にこれだけ戻るまで再開しない。
#define SUPPLY_VOLTAGE_RECOVER_HYST 0.5f

// ===========================================================================
// 通信
// ===========================================================================
// 状態フレームの送信間隔 [μs]。上位の制御周期 (500us) に合わせる。
// 11バイト = 1Mbps で 110us。ボーレートとセットで決めること。
#define SERIAL_SEND_INTERVAL_US 500

// 無通信でこの時間 [s] が経つと停止モードに入る。通信断 (断線・上位のハング) の保険。
// 上位は止めたいときトルク0や制動を明示的に送る (送信をやめて止めると、
// この時間ぶん直前のトルクが残るため)。
#define SERIAL_TIMEOUT_S 0.5f

// メインループのウォッチドッグ (IWDG) のタイムアウト [ms]。メインループが止まると、
// 20kHz割り込みは最後の指令を出し続け、上の無通信タイムアウトも判定されなくなる。
// LSI のばらつき (30〜50kHz) で実際は 160〜270ms に振れる。printf のブロッキング
// (過電流の状態表示で数十ms) より十分長く取ること
#define WATCHDOG_TIMEOUT_MS 200

// **一時的な試験用。普段は必ず 0。** 1 にすると上位からの指令を無視し、起動後に自分で回る
// (停止 → 10 / 30 / 120 rad/s をエンコーダ補正テーブルあり/なしで 8s ずつ → 停止 を繰り返す。
//  手順は app.c の SelfTestRun の PLAN)。
// 上位なしで回転中の割り込み時間 (PROFILE_ISR) や状態表示を測るためのもの。トルク上限は
// SELF_TEST_TORQUE_NM。校正値が無ければ回らない。異常処理 (過電流・過熱・電圧) は通常どおり働く
#define SELF_TEST_RUN 0
#define SELF_TEST_TORQUE_NM 0.1f

// 異常が続いている間の printf の間隔 [ms] (ブロッキングなので毎周は出さない)
#define FAULT_PRINT_INTERVAL_MS 1000

// 1回の RecvSerial で処理する最大バイト数。
// 上位は 2kHz × 6バイトで送ってくる。メインループが詰まって溜まった分を数フレーム単位で
// 吐き出せるようにしつつ、連続受信でループが戻らなくなるのを防ぐ上限。
#define SERIAL_RX_BYTES_PER_CALL 32

// 上位から受け取る制限値は **トルクのみ** (速度は上位の指令値そのもので決まる)。
// MD は受信値を信用せず、MAX_CURRENT 由来の上限 (Kt × MAX_CURRENT) で頭打ちにし、
// 実際に適用した値を状態フレームの byte9 でエコーバックする。
// 起動直後の既定値は 0 (動かない)。「0 = 無制限」にしてはいけない。
// 速度側は MAX_ANGULAR_SPEED が MD 固定のハード保護として速度指令をクランプする (通信には載せない)。

// printf での状態表示の間隔 [s]。0 で無効 (コードごと削除)。PIDゲイン調整時に 0.5f 程度。
#define STATUS_PRINT_INTERVAL_S 0

// ===========================================================================
// 実行時間プロファイル (DWTサイクルカウンタ)
// ===========================================================================
// 20kHz制御ループの1回あたりの実行時間を実測する。制御周期を上げる/処理を足す前に確認すること。
//   0 : 無効 (コードごと削除)
//   1 : 割り込み全体と呼び出し周期のみ (オーバーヘッド最小)
//   2 : 内訳 (オブザーバ / 電流ループ / 外側ループ) も測る。全体が 0.5µs ほど増える
#define PROFILE_ISR 0

// プロファイルの表示間隔 [s]。0 で表示しない。printf はブロッキングだが、
// 制御ループは割り込み優先度0なので影響を受けない。
#define PROFILE_PRINT_INTERVAL_S 0

// ===========================================================================
// PWM / 制御周期
// ===========================================================================
// TIM1 はセンター揃え。1周期 = 2 × ARR カウント → 72MHz / (2 × 1800) = 20kHz。デューティ = CCR / ARR。
// (詳細は docs/OPTIMIZATION.md)
#define PWM_ARR 1800
#define PWM_FREQ 20000.0f  // PWM周波数 = 電流ループ周波数 [Hz]

// デッドタイム [カウント]。tim.c の sBreakDeadTimeConfig.DeadTime と一致させる。
// DTG = 20, tDTS = 1/72MHz → 278ns。
#define PWM_DEADTIME_COUNTS 20

#define CURRENT_LOOP_DT (1.0f / PWM_FREQ)  // 電流ループ周期 [s] (50µs)

// 外側ループはADC完了割り込みを分周して回す (角速度は分周せず、20kHzのオブザーバから得る)。
#define OUTER_LOOP_DIV 20  // 速度/位置制御 → 1kHz
#define OUTER_LOOP_DT (CURRENT_LOOP_DT * OUTER_LOOP_DIV)

// ---------------------------------------------------------------------------
// デューティの上限
// ---------------------------------------------------------------------------
// ローサイドシャントは低側FETがONの区間しか相電流が流れない。センター揃えではこの区間が
// カウンタ頂点を中心に左右対称に広がり、片側の幅は (PWM_ARR - CCR) カウント。
// サンプリングは頂点付近で行うので、頂点の手前側に次の時間が収まる必要がある:
//   必要 = デッドタイム + アンプ整定 + トリガ前倒し = 20 + 144 + 50 = 214 カウント
//   使える = PWM_ARR - MAX_DUTY_CCR = 216 カウント  ✓
//
// 整定時間 144カウント (2.0µs) の根拠: INA181A1 は帯域 350kHz の1次系 (τ = 455ns)、
// 1%整定 = 4.6τ = 2.1µs、データシート実測 1.6µs typ。**オシロでの実測値ではなく保守側の値。**
// 詰めると高デューティ域だけ電流値が嘘になるので、変更時は docs/OPTIMIZATION.md の
// 「ADCで整定時間を測る」を参照。
#define CURRENT_SENSE_SETTLING_COUNTS 144

// 上限・下限は _Static_assert で使うため、デューティではなく CCR カウント数で定義する。
#define MAX_DUTY_CCR 1584  // 1584 / 1800 = 0.880
#define MIN_DUTY_CCR 36    //   36 / 1800 = 0.020

#define MAX_DUTY ((float)MAX_DUTY_CCR / (float)PWM_ARR)

// 電圧ベクトルの大きさの上限 (対 母線電圧)。三次高調波重畳SVPWMでの相電圧振幅の上限。
#define MAX_MODULATION_RATIO ((MAX_DUTY - 0.5f) * 1.1547005f)

// ===========================================================================
// 電流センシング (ローサイドシャント + INA181A1)
// ===========================================================================
// 回路: CurcuitV4 R16/R24 = 5mΩ, U4/U6 = INA181A1。
// REF は 1k/1k 分圧で 1.65V なので、無電流時の出力は ADC 2048 で正負どちらの電流も読める。
#define SHUNT_RESISTANCE 0.005f  // シャント抵抗 [Ω]
#define CURRENT_AMP_GAIN 20.0f   // INA181A1 のゲイン [V/V]

#define CURRENT_REF_ADC 2048.0f       // 無電流時の出力(理論値) [ADC]
#define CURRENT_OFFSET_TOLERANCE 250  // オフセット校正値の許容ずれ [ADC]

// ゼロ点校正 (0.5秒) の前後でエンコーダの生値がこれより動いていたら「回転中」とみなして
// やり直す。40 LSB ≒ 0.06rad (0.5秒で 0.12rad/s)。静止時のノイズ (数LSB) より十分大きい
#define CURRENT_CALIB_MAX_ENCODER_MOVE_LSB 40
#define CURRENT_CALIB_MAX_ATTEMPTS 6  // 校正の試行回数の上限 (約3秒)

// ADCトリガ位置: カウンタ頂点から何カウント手前で叩くか。
// TIM1_CH4 を PWM2 モードにして CCR4 = PWM_ARR - この値 とし、OC4REF → TRGO2 → ADC1外部トリガ。
// 低側ON区間の中央 (頂点) をまたいでサンプリングし、三角波リプルの平均値を得る。
//   2ch連続変換: トリガから2ch目のサンプリング終了まで 74 + 61.5 = 135.5 ADCサイクル (72MHz)
//   中央に合わせるなら 68 カウント手前だが、整定時間の制約のほうが厳しいので 50 にしている
//   (取得区間の中心は頂点の 18 カウント後ろ。実害なし)。
#define CURRENT_SENSE_TRIG_ADVANCE 50

// トリガから2ch目のサンプリングが終わるまで [カウント]。(61.5+12.5) + 61.5 = 135.5 → 135
#define CURRENT_SENSE_ACQ_COUNTS 135

// --- 設定の整合チェック ---
// PWM周波数・MAX_DUTY・トリガ位置・サンプリング時間は互いに縛り合っており、どれかを触ると
// 電流値だけが静かに壊れる。ビルドで検出する。
// (メッセージがASCIIなのは、GCCが非ASCIIを8進エスケープに潰して読めなくなるため)

// (1) 頂点の手前側: 低側FETがONしてアンプが整定してからトリガが来ること
_Static_assert((PWM_ARR - CURRENT_SENSE_TRIG_ADVANCE) - (MAX_DUTY_CCR + PWM_DEADTIME_COUNTS) >=
                   CURRENT_SENSE_SETTLING_COUNTS,
               "MAX_DUTY_CCR too high: ADC samples before the current amp settles. "
               "Lower MAX_DUTY_CCR or CURRENT_SENSE_TRIG_ADVANCE.");

// (2) 頂点の奥側: 2ch目のサンプリングが終わる前に低側FETがOFFにならないこと
_Static_assert((CURRENT_SENSE_ACQ_COUNTS - CURRENT_SENSE_TRIG_ADVANCE) <=
                   (PWM_ARR - MAX_DUTY_CCR),
               "ADC acquisition runs past the low-side ON window. "
               "Raise CURRENT_SENSE_TRIG_ADVANCE or lower MAX_DUTY_CCR/sampling time.");

// (3) 下限が上限を下回っていること
_Static_assert(MIN_DUTY_CCR >= 0 && MIN_DUTY_CCR < MAX_DUTY_CCR && MAX_DUTY_CCR < PWM_ARR,
               "Duty CCR limits are inconsistent.");

// (4) トリガ位置がカウンタ範囲に収まっていること
_Static_assert(CURRENT_SENSE_TRIG_ADVANCE > 0 && CURRENT_SENSE_TRIG_ADVANCE < PWM_ARR,
               "CURRENT_SENSE_TRIG_ADVANCE out of range.");

// 割り込みがこの時間 [µs] を超えるとデューティの反映が1周期ずれる。
// CCRはプリロード付きで、センター揃えの更新イベントは頂点と谷の両方で起きる。書き込みが
// 谷に間に合わないと次の頂点で反映され、低側ON区間が非対称になってサンプリング点がずれる。
//   使える時間 = 谷までの 25.0µs - 頂点→2ch目変換完了 1.36µs - 割り込み応答 約0.2µs = 23.4µs
// PROFILE_ISR 有効時、割り込みの入口から CCR を書き込むまでの時間 (表示の「PWM書込」) の最大値が
// これを超えると警告が出る。外側ループは書き込みの後に回すので、割り込み全体の時間とは別物。
#define ISR_DEADLINE_US 23.4f

// 電流の符号。シャントはGND側にあり、モータへ流れ出す向き(正)の電流ではアンプ出力が REF より下がる。
// よって「(ADC値 - オフセット) × -1」が相電流になる。
#define CURRENT_SIGN (-1.0f)

// 測定電流のローパス係数 (1.0で無フィルタ)。fc = fs × -ln(1-a) / 2π (fs = 20kHz)
//   a=0.25 → 916Hz,  a=0.5 → 2206Hz,  a=0.8 → 5.1kHz
// 頂点サンプリングなので1サンプルがその周期の平均電流であり、リプル除去は不要。
// 役割はスパイク除去のみで、位相遅れは電流ループ帯域を制限する。
// a=0.5 なら 700Hz に対する位相遅れは 17.6°。
#define CURRENT_LPF_COEF 0.5f

// ===========================================================================
// BLDCのパラメーター
// ===========================================================================
#define POLE_PAIRS 7              // 極対数 (磁石の数/2)
#define MAX_ANGULAR_SPEED 150.0f  // 最大角速度 [rad/s]
#define MAX_ANGULAR_ACCEL 150.0f  // 最大角加速度 [rad/s^2]

// ブレーキモードの境界層幅 [rad/s]。
// 制動電流を -brake_current × sign(ω) にするとv=0付近でチャタリングするので、
// sign の代わりに tanh(ω / この値) を使って境界層内を滑らかに0へつなぐ。
#define BRAKE_BOUNDARY_SPEED_RAD_S 20.0f

// ブレーキモードの不感帯 [rad/s]。tanh は v=0 でも傾きを持つため、静止付近の速度推定の
// 揺らぎが微小トルクのディザになる。この速度未満ではトルクを完全に0にする。
#define BRAKE_DEADBAND_SPEED_RAD_S 2.0f

// ===========================================================================
// 角度追従オブザーバ (2次PLL)
// ===========================================================================
// 推定角 θ̂ を観測角に追従させるループの内部状態として θ̂ と ω̂ を同時に得る。
//   e   = θ_meas - θ̂
//   ω̂ += PLL_KI * e * dt
//   θ̂ += (ω̂ + PLL_KP * e) * dt
// 閉ループは標準2次系で ω_n = √KI, ζ = KP / (2√KI)。ζ=1 (臨界制動) として
// KP = 2·ω_n, KI = ω_n² とするので、調整は PLL_OMEGA_N だけでよい。
// ω_n が大きいほど追従が速いがエンコーダのノイズを拾う。整定時間は約 4/ω_n。
// 周波数誤差からの引き込み上限は PLL_KP 程度なので、PLL_KP ≥ MAX_ANGULAR_SPEED なら
// どの運転速度からでも再ロックできる。
#define PLL_OMEGA_N 900.0f
#define PLL_KP (2.0f * PLL_OMEGA_N)         // 2ζω_n [1/s]
#define PLL_KI (PLL_OMEGA_N * PLL_OMEGA_N)  // ω_n²  [1/s²]

// --- 観測値の棄却条件 ---
// 「観測できない」と「推定がずれている」を区別すること。混ぜると、ロータを急停止させたとき
// θ̂ の自走を異常な観測として棄却し続け、永久にロックが戻らなくなる。

// (a) 飽和の検出。生のADC値がレール付近 (AS5600のアナログ出力の飽和域) なら角度情報が
//     無いので、そのサンプルを弾いて ENCODER_REJECT_MAX サンプルまで外挿する。
//     レール判定の幅は校正時に静止ノイズ σ から決めてフラッシュに保存する (固定値は持たない)。
#define ENCODER_REJECT_MAX 1000  // 1000 × 50µs = 50ms

// (a2) 飽和を抜けた直後も、このサンプル数だけ飽和と同じく棄却して外挿する。
//      継ぎ目では出力が一方のレールから反対のレールへ移る途中の値を拾う (ADC の平均窓 約38µs も
//      跳びをまたぐと中間値になる)。その値は「継ぎ目の手前のそれらしい角度」に見えて (b) の判定を
//      すり抜ける (2026-10-19 実機: 飽和から1サンプル目に生値 3983、イノベーション 0.19rad)。
//      4サンプル = 200µs。150 rad/s でも外挿する角度は 0.03rad。校正のビン集計も同じ区間を除く
#define ENCODER_SAT_HOLDOFF_SAMPLES 4

// (b) イノベーション過大 [rad]。0/2π遷移中のグリッチか本当のずれかは1サンプルでは区別できない
//     ので、ENCODER_GLITCH_MAX サンプルまで様子を見て、続くなら棄却をやめてPLLに再ロックさせる。
//     継ぎ目を外挿で渡った直後の実測 emax ≒ 0.09rad に対し約2.7倍の余裕を取ってある
//     (近すぎると偶然の連続超過で再取得モードに入り、速度スパイクが復活する)。
//     グリッチは中間値を拾い最大πになるので 0.25rad でも確実に捕まる。
#define ENCODER_INNOVATION_LIMIT_RAD 0.25f
#define ENCODER_GLITCH_MAX 20  // 20 × 50µs = 1ms

// 速度推定(積分パス)に渡すイノベーションの上限 [rad]。**ロック中のみ適用。**
// ロック中の小さなイノベーションは継ぎ目の段差や外挿誤差であって本物の回転ではない。
// 全量を積分に入れると1回転ごとの速度スパイクになる。比例パスは制限しないので段差は角度補正として吸収される。
// 再取得中に制限すると dω̂/dt が頭打ちになり、急減速に追従できず戻れなくなる。
// 目安: 角加速度 a による定常イノベーションは a / PLL_KI。0.005rad は
// ω_n=900 で 4050 rad/s² 相当。
#define PLL_SPEED_ERROR_LIMIT_RAD 0.005f

// ===========================================================================
// 電流制限・保護
// ===========================================================================
// Id/Iq指令の上限 [A]。トルクの絶対上限 = Kt × MAX_CURRENT。上げるときは次を確認すること:
//   - OVERCURRENT_LIMIT : これより下だと保護が先に飛ぶ。25%の余裕を取る
//   - 電流センスのフルスケール ±16.5A (5mΩ × 20V/V)。OVERCURRENT がここに近いと測定値が飽和する
//   - プロトコルの torque_limit は u8 × 0.001 = 0.255 N・m 天井 (≒ 13.1A 相当)
//   - FET (SSM6K819R ×6) とシャント (1206 5mΩ) の発熱 (TEMP_LIMIT で監視)
#define MAX_CURRENT 10.0f        // Id/Iq指令の上限 [A]
#define OVERCURRENT_LIMIT 15.0f  // 過電流保護のしきい値 [A] (MAX_CURRENT の 1.5倍)

// 連続して何サンプルしきい値を超えたら保護を発動するか (5 → 250µs)。単発ノイズの誤検出防止。
#define OVERCURRENT_TRIP_COUNT 5

// 過速度保護: 推定速度の絶対値が MAX_ANGULAR_SPEED × この倍率を OVERSPEED_TRIP_MS 続けて超えたら
// 止めてラッチする (過電流と同じ扱い。スイッチで復帰)。速度指令は MAX_ANGULAR_SPEED でクランプして
// いるので、これを超えるのは電気角が狂ってトルクが逆向きに出る暴走か、外から回されたとき
// (2026-10-19 に +30 rad/s 指令で −187 rad/s まで暴走した。それまで速度の保護は無かった)
// このしきい値は速度・位置モードだけ。トルク・制動・停止モードは下の OVERSPEED_DIRECT_IQ_RAD_S。
#define OVERSPEED_LIMIT_RATIO 1.2f
#define OVERSPEED_TRIP_MS 50
// トルク・制動・停止モードの過速度のしきい値 [rad/s]。後輪の駆動ではここで回るのが正常なので
// MAX_ANGULAR_SPEED と切り離す (車輪半径 0.03m で 180 rad/s = 5.4m/s。車速 5m/s では空転込みで
// 後輪が 6〜7m/s = 200〜230 rad/s まで回る。2026-11-08 の記録で車速 3.9m/s のとき後輪÷車速が最大 1.37)。
// 270 rad/s = 8.1m/s は、メイン STM32 が後輪の周速 7.5m/s (250 rad/s。DRIVE_WHEEL_LIFT_MAX_WHEEL_SPEED_M_S)
// でトルクを 0 にする防壁より上に置き、無負荷の天井 (約 406 rad/s) よりは下に残して暴走を捕まえる。
// トレードオフ: 上限より下でつり合う暴走 (電気角のずれでトルクが弱まった場合など) は捕まえられない
#define OVERSPEED_DIRECT_IQ_RAD_S 270.0f

// ---------------------------------------------------------------------------
// 電流PI制御のゲイン
// ---------------------------------------------------------------------------
// 設計式: Kp = L × ω_bw, Ki = R × ω_bw。PIのゼロ点 Ki/Kp がプラントの極 R/L を打ち消し、
// 閉ループは帯域 ω_bw の1次系になる。L と R はスイッチ校正の実測値 (フラッシュ) を使う。
//
// 帯域の上限はプラントではなく位相遅れで決まる (700Hz のとき):
//   1.5周期の演算遅れ 18.9° + 電流LPF 17.6° → 位相余裕 約53°。700Hz 前後が現実的な上限。
//
// 実際に達成したい閉ループ帯域 [Hz]。遅れのぶん実測は設計値より低く出るので、校正で
// 電流ステップを打って実測し、実測帯域がこの値になるよう設計帯域を補正して保存する。
#define CURRENT_BW_TARGET_HZ 700.0f

// ---------------------------------------------------------------------------
// 速度ループ (外側ループ) のゲイン
// ---------------------------------------------------------------------------
// プラントは Iq → ω = 1 / ((J/Kt)·s)。必要なのは J/Kt [A·s²/rad] だけで (Kt も J も単独では不要)、
// 校正でトルクステップの加減速から直接測る。
//   Kp = (J/Kt) × 2π × SPEED_BW_HZ           [A/(rad/s)]
//   Ki = Kp × 2π × SPEED_BW_HZ / SPEED_KI_RATIO
// 加えて、速度指令ランプの加速度 × (J/Kt) と、実測した摩擦電流をフィードフォワードする。
//
// 帯域の上限: 速度フィードバックは角度オブザーバ (PLL_OMEGA_N) の遅れを通り、
// 20Hz で位相遅れ 約16° + 電流ループ 約10° → 位相余裕 約64°。PLL_OMEGA_N の 1/5 以下に収めること。
#define SPEED_BW_HZ 20.0f

// 積分の折点 (rad/s) = 2π·SPEED_BW_HZ / SPEED_KI_RATIO。大きいほど積分が速く、
// 摩擦外乱を早く消すが、オーバーシュートが増える。
#define SPEED_KI_RATIO 5.0f

// ---------------------------------------------------------------------------
// 逆起電力・dq干渉のフィードフォワード
// ---------------------------------------------------------------------------
//   Vd = R·Id + L·dId/dt − ω_e·L·Iq
//   Vq = R·Iq + L·dIq/dt + ω_e·L·Id + ω_e·ψm
//                          └─ dq干渉 ─┘ └ 逆起電力 ┘
// 速度に比例するこれらの項を先に計算してPIの出力に足し、PIはモデルで説明できない残りだけを担当する。
// 効果は応答が速度に依存しなくなること (モデル検証: 160rad/s で 1.55ms → 0.55ms) と、
// 積分項が電圧余裕を食わないこと。
// **符号を間違えると外乱が倍になる。** 実機では STATUS_PRINT の Vq(FF...) を見て、
// FFがVqと同符号で速度とともに大半を占めていれば正しい。
#define CURRENT_FF_ENABLE 1

// FFが使ってよい電圧の割合 (変調限界に対して)。FF単独で限界を超えると、PIはFFの出しすぎを
// 打ち消すだけになり、アンチワインドアップが積分項を縮め続けて制御を失う。残り15%がPIの取り分。
#define CURRENT_FF_MAX_RATIO 0.85f

// ---------------------------------------------------------------------------
// スイッチ校正 (モータ定数の自動測定)
// ---------------------------------------------------------------------------
// スイッチを押しながら起動すると、次の順に実測し、**全部成功したときだけ**フラッシュに保存する (1分以内。実際の所要時間は終わりに表示する)。
//   1. R, L          : 強制角で Vd を直接印加 (PIバイパス)。電気角6か所 × 4電圧。ロータは d軸に引き込まれるだけ
//   2. 電流ループ帯域 : Id ステップ (4回同期加算) の実測から設計帯域を補正 (CURRENT_BW_TARGET_HZ に合わせる)
//   3. エンコーダ     : 電流制御の強制転流。レールをヒストグラムで決め、正逆1周ずつ回して盲点・方向・d軸オフセット
//   4. J/Kt と摩擦    : トルクモードで加速→減速。正逆それぞれ2つの電流で1回ずつ。**ロータが回る**
//   5. 補正テーブル   : 出力を切った惰性回転 (正逆2回ずつ) で、センサの非線形 (偏心・INL) を測る。**ロータが回る**
//   6. ψm と角度遅れ  : 速度制御で正逆8点 (各0.5秒) を掃引。静的な電気角オフセットも補正する。**ロータが回る**
//   7. 確認試験       : 継ぎ目の段差 emax と、速度ランプへの追従 (行き過ぎ・残留誤差)。不合格なら保存しない
// 順序の理由: 2,3 は 1 の電流PIゲインが要る / 4 は電気角 (3) が要る / 5 は惰性で回る開始速度を
//            摩擦と J/Kt (4) から決め、速度ゲイン (4) で回す / 6 は補正テーブル (5) を入れた角度で測る
//            (テーブルなしだと電気角が揺れ、Vq の平均が縮んで ψm と Kt を低く読む)。
// 校正中はメインループが止まるので、母線電圧は校正が ADC から直接読んで追従する。
// モータ定数がフラッシュに無いときは駆動しない (既定値は持たない。BLDC_IsCalibrated)。
//
// 校正に流す電流 = CALIB_CURRENT_RATIO × MAX_CURRENT。各測定の電圧・電流・速度はここから自動で決まる。
// 大きいほど摩擦・コギングに対して精度が上がるが発熱が増える。
// エンコーダ校正 (強制転流) はこの2倍を流す (保持を強くして負荷の摩擦・コギングによる遅れを減らす。2倍が MAX_CURRENT 以下であること)。
#define CALIB_CURRENT_RATIO 0.3f
_Static_assert(2.0f * CALIB_CURRENT_RATIO <= 1.0f, "Encoder calibration uses 2x CALIB_CURRENT.");

// 角度の遅れ補償の初期値 [s]。校正 6 の掃引で実測値に置き換わる。
// 制御用の電気角には実ロータ位置に対する時間遅れがあり、回転中は δ = ω_e × 遅れ時間 の
// 角度ずれになる。ω̂ は分かっているので、推定角をこのぶん進めて打ち消す。
//   AS5600 の内部フィルタ 約1.0ms (支配的) + 演算遅れ (1.5周期) 0.075ms
// 1次フィルタの等速入力に対する遅れは時定数ぶんなので、等速回転に対しては原理的に正確。
// センサの物理特性なので、未校正時の初期値としてだけ残している。
#define ANGLE_DELAY_DEFAULT 0.00108f

// ステップ応答の記録サンプル数 (200 × 50µs = 10ms)。R,L と電流帯域の測定で使う
#define BLDC_CAPTURE_SAMPLES 200

// エンコーダ補正テーブルの点数 (機械角1周)。2のべき乗。1点 int16 でフラッシュに保存する
#define ENCODER_LUT_SIZE 128
_Static_assert(ENCODER_LUT_SIZE >= 16 && (ENCODER_LUT_SIZE & (ENCODER_LUT_SIZE - 1)) == 0,
               "ENCODER_LUT_SIZE must be a power of two (bin index uses a mask).");

// ===========================================================================
// エンコーダの ADC (ADC2)
// ===========================================================================
// ADC2 の regular 変換列は [エンコーダ × ENCODER_ADC_SAMPLES, 電源電圧, 温度] の連続変換・DMA循環。
// 制御ループは毎周期エンコーダの全サンプルを平均する (約38µs の窓 ≒ PWM 1周期の大半)。
// 単発1変換だとPWMのスイッチングノイズがそのまま乗るが、周期の大半を平均すると打ち消し合い、
// 白色ノイズも 1/√N になる。平均の遅れ (約25µs) は角度遅れの同定に自動で含まれる。
//   1変換 = (181.5 + 12.5) / 72MHz = 2.69µs、エンコーダ14回 = 37.7µs、電圧・温度 各8.5µs
#define ENCODER_ADC_SAMPLES 14
#define SENSOR_ADC_CHANNELS (ENCODER_ADC_SAMPLES + 2)  // DMA バッファの長さ (最大16 = rank数の上限)
#define SENSOR_ADC_SUPPLY_VOLT ENCODER_ADC_SAMPLES     // 電源電圧の添字
#define SENSOR_ADC_TEMP (ENCODER_ADC_SAMPLES + 1)      // 温度の添字

_Static_assert(SENSOR_ADC_CHANNELS <= 16, "ADC2 regular sequence has at most 16 ranks.");

#endif  // CONFIG_H_
