banbatakumi/BLDC/(commit log)

2025-06-04 大体の部品追加
    [CurcuitV1.kicad_pcb, CurcuitV1.kicad_sch]
2025-06-05 水晶追加など
    [CurcuitV1.kicad_pcb, CurcuitV1.kicad_sch]
2025-06-05 一旦ジェネレートしてみた
2025-06-05 基板外径仮案
    [CurcuitV1.kicad_pcb, CurcuitV1.kicad_sch]
2025-06-05 ピン設定変更
2025-06-05 大体完成
    [CurcuitV1.kicad_pcb, CurcuitV1.kicad_sch, pcb.dxf]
2025-06-05 ピンほぼ決定
2025-06-05 LED配線
    [CurcuitV1.kicad_pcb, CurcuitV1.kicad_sch]
2025-06-05 ADCのピン設定
2025-06-05 発注した
    [CurcuitV1.kicad_pcb, CurcuitV1.kicad_sch, bom.csv, designators.csv, positions.csv]
2025-06-07 Fusion用の画像出力
2025-06-09 PWMとADCの設定
2025-06-09 makeできた
2025-06-09 app追加
2025-06-10 gitignoreの追加
2025-06-10 Lチカできた
2025-06-10 mymathの追加&命名変更
2025-06-10 pwm成功
2025-06-10 タイマー追加
2025-06-10 uvwのpwm出力確認
2025-06-10 オープンループコントロール
2025-06-12 ADCの設定ちょっと変更
2025-06-12 V1.1発注
    [CurcuitV1.kicad_pcb, CurcuitV1.kicad_sch, bom.csv, designators.csv, positions.csv]
2025-06-20 製造ファイル
2025-06-20 動作試験
2025-06-24 デバッグ
2025-06-25 DRV8300のライブラリを追加
    [CurcuitV2.kicad_pcb, CurcuitV2.kicad_sch]
2025-06-25 必要な部品の挿入ほぼ完了
    [CurcuitV2.kicad_pcb, CurcuitV2.kicad_sch, pcb.dxf]
2025-06-25 CubeMX生成
    [CurcuitV2.kicad_pcb, CurcuitV2.kicad_sch]
2025-06-26 ほぼ完成
    [CurcuitV2.kicad_pcb, CurcuitV2.kicad_sch]
2025-06-27 製造ファイル生成
    [CurcuitV2.kicad_pcb, bom.csv, designators.csv, positions.csv]
2025-06-27 理想ダイオードの追加
    [CurcuitV2.kicad_sch, bom.csv, designators.csv, positions.csv]
2025-06-28 シルクの追加
    [CurcuitV2.kicad_pcb, CurcuitV2.kicad_sch, CurcuitV2.step]
2025-06-28 GNDビア修正
    [CurcuitV2.kicad_pcb]
2025-06-29 GNDビアの修正
    [CurcuitV2.kicad_pcb]
2025-06-30 電源LEDの追加
    [CurcuitV2.kicad_pcb, bom.csv, designators.csv, positions.csv]
2025-06-30 ちょっとした修正
    [CurcuitV2.kicad_sch]
2025-06-30 NRSTのプルアップ
    [CurcuitV2.kicad_pcb, CurcuitV2.kicad_sch]
2025-06-30 NRSTに0.1uf追加
    [CurcuitV2.kicad_pcb, CurcuitV2.kicad_sch, bom.csv, designators.csv, positions.csv]
2025-06-30 リファレンス削除
    [CurcuitV2.kicad_pcb]
2025-06-30 配線修正
    [CurcuitV2.kicad_pcb]
2025-07-04 最終発注ファイル
2025-07-07 強制転流で回った！
2025-07-08 adc読めた
2025-07-08 gitignore追加
2025-07-08 キャッシュ削除
2025-07-08 エンコーダー使ったBLDCの制御できた！
2025-07-08 速度制御できた！
2025-07-08 ちゃんと使えるくらいの制御できた
2025-07-08 エンコーダー値にlpfかけた
2025-07-08 制御周期変更
2025-07-09 位置制御追加
2025-07-09 正逆で消費電流が異なる問題ちょっと解決
2025-07-10 バグ修正
2025-07-10 なんかおかしいと思ったらエンコーダーのオフセットするの忘れてた！直った！寝る！
2025-07-11 エンコーダー初期化処理の変更
2025-07-11 オフセット値を初期設定するようにした
2025-07-11 コメントアウト追加
2025-07-11 オーバーヒートで機能を停止するようにした
2025-07-11 電源電圧の制限
2025-07-11 lpfフィルタライブラリの追加
2025-07-12 エンコーダー値に可変ゲインLPFをかけて低速時に安定させた
2025-07-12 ポジションコントロールPIDを可変Dゲインにした
2025-07-17 新しいBLDCにパラメーターを調整した
2025-07-19 uart2でシリアル通信できた
2025-07-19 タイマー割り込みで2khz制御実装and UARTのバッファクリア処理など通信関連の改善
2025-07-20 コメントアウトの整理
2025-07-20 atan2近似などにより処理の高速化
2025-07-20 最大加速度を制限かけた
2025-07-20 uartを全部dmaにした
2025-07-20 制御周期早くした
2025-07-21 高速域回るようになった
2025-07-24 進化した（忘れた）
2025-07-24 フラッシュにエンコーダーのオフセットなどを保存できるようにした
2025-07-24 環境構築＆GPTで生成したコード貼り付け
2025-07-24 制御モードの追加
2025-07-24 送信値の修正
2025-07-24 キャッシュクリア
2025-07-24 gitignore修正
2025-07-26 uartの通信プロトコル仮確定
2025-07-29 高周波化&速度測定周期変更
2026-03-31 割り込みの開始をセットアップ後に変更
2026-05-03 ブレーキ実装
2026-05-07 floatに統一
2026-05-07 データ型をdoubleからfloatに変更し、ローパスフィルタの初期化と更新関数を最適化
2026-05-07 ADCサンプリング時間を19サイクルから7サイクルに変更し、BLDC制御の最適化を実施
2026-05-07 ADCサンプリング時間を19サイクルおよび181サイクルに変更し、設定を最適化。温度制限を70°Cに更新。
2026-05-08 RCC設定を最適化し、タイマーのプリスケーラと周期を調整。BLDC制御のPIDパラメータを更新し、LED制御のロジックを修正。
2026-05-08 タイマー設定を最適化し、BLDC制御の三相正弦波生成をarm_mathライブラリを使用して改善。ADCサンプリング時間を調整し、コードの可読性を向上させるために一貫性を持たせた。
2026-05-08 Refactor main application and remove TIM6 functionality
    - Removed TIM6 initialization and interrupt handling from main.c and stm32f3xx_it.c.
    - Updated the timer initialization for TIM1, TIM2, and TIM3 in tim.c.
    - Refactored the main application logic in app.c to handle serial communication and control modes without relying on TIM6.
    - Introduced a new RecvSerial function to manage incoming serial data and control modes.
    - Updated the SendSerial function to send relevant data at specified intervals.
    - Removed unnecessary variables and simplified the control flow in the MainApp function.
    - Added a new mymath library for sine calculations, including a sine table.
    - Updated the BLDC control logic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
2026-05-12 Refactor BLDC control structure and update variable names for clarity; optimize function signatures and enhance angular speed control logic.
2026-05-14 Refactor BLDC control logic: rename target_torque to target_voltage, update control functions, and optimize filter coefficients for improved performance.
2026-05-16 Refactor BLDC control functions: simplify BLDC_Stop function, enhance control logic, and update MAX_AMP_VOLT to improve performance.
2026-05-19 Refactor BLDC control logic: update TIM1 period for improved timing accuracy, modify serial data structure to include temperature, and enhance PID control logic with integral enable flag.
2026-05-28 Copy From V2
    [CurcuitV3.kicad_pcb, CurcuitV3.kicad_sch, pcb.dxf]
2026-05-28 電流センス部品の追加
    [CurcuitV3.kicad_pcb, CurcuitV3.kicad_sch]
2026-05-29 回路ほぼ完成
    [CurcuitV3.kicad_sch]
2026-05-29 MX生成
2026-05-30 回路完成
2026-05-30 シルク書いた
    [CurcuitV3.kicad_pcb, CurcuitV3.kicad_sch]
2026-06-03 製造ファイル再生成
    [CurcuitV3.kicad_pcb, CurcuitV3.step]
2026-06-05 V3の修正と製造ファイル生成
    [CurcuitV3.kicad_pcb, CurcuitV3.kicad_sch, positions.csv]
2026-07-11 電流読めた
2026-07-12 Implement CurrentSense_Init for PWM synchronized current sensing initialization
2026-07-12 V4完成&製造ファイル生成
    [CurcuitV4.kicad_pcb, CurcuitV4.kicad_sch, bom.csv, designators.csv, pcb.dxf, positions.csv]
2026-07-13 TVSダイオードの追加とGNDビア増やした
    [CurcuitV4.kicad_pcb, CurcuitV4.kicad_sch, bom.csv, designators.csv, positions.csv]
2026-07-28 bom生成
2026-07-28 V3からのコピー
2026-07-28 FOCできた
2026-07-29 feat: Enhance BLDC encoder handling and output control
    - Introduced encoder dead zone handling to account for saturation effects.
    - Added statistics tracking for encoder saturation and glitches.
    - Implemented output enable/disable functionality to prevent short-circuiting during coasting.
    - Updated encoder scale calculation to consider dead zone width.
    - Improved angle tracking observer to handle encoder glitches and saturation more effectively.
    - Enhanced encoder calibration process to measure dead zone width.
    - Added flash data structure to store encoder calibration values, including dead zone.
    - Updated initialization and encoder setting functions to accommodate new parameters.
    - Added fu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
    [app.c, bldc.c, bldc.h, config.h]
2026-07-29 FOCの解説
2026-07-29 feat: Update LED behavior and error handling; adjust control gains
    [app.c, bldc.c, config.h]
2026-07-29 feat(bldc): Enhance BLDC control with new motor parameters and profiling
    - Updated BLDCFlashData structure to include motor electrical parameters: resistance (R), inductance (L), back EMF constant (ψm), and angle delay.
    - Changed BLDC_FLASH_MAGIC to reflect the addition of new parameters.
    - Modified BLDC_Init function to accept supply voltage for accurate voltage-to-duty conversion.
    - Added functions for motor constant measurement and angle delay identification.
    - Implemented ISR profiling for performance monitoring in the control loop.
    - Improved current sensing initialization to optimize ADC triggering and reduce unnecessary interrupts.
    - Enhanced FOC calculations with a more efficient si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
2026-07-29 Refactor ADC configuration and current sensing logic
    - Consolidated ADC conversion constants into config.h to avoid duplication and potential discrepancies.
    - Updated maximum current limit from 7.0A to 8.0A for improved performance.
    - Enhanced the BLDC control logic by introducing a new function to check for encoder saturation, ensuring consistent behavior during calibration and operation.
    - Improved PID control logic to handle output saturation more effectively, preventing integral windup.
    - Removed redundant offset validation logic in current sensing, streamlining the calibration process.
    - Updated comments and code formatting for better readability and maintenance.
    [app.c, bldc.c, bldc.h, config.h, current_sense.c, current_sense.h]
2026-08-03 feat(bldc): Add torque control modes and update serial command structure
2026-08-06 Refactor BLDC control and add unit tests for protocol and limits
    - Updated BLDC header to remove PWM dependency and include TIM for direct PWM output.
    - Revised position control logic to eliminate speed limiting, allowing direct error input into PID.
    - Introduced torque limit handling in position control, ensuring it governs holding torque during constraints.
    - Added new functions to set and get torque limits, enhancing control over motor behavior.
    - Created a Makefile for host-side tests, enabling easy build and execution of test cases.
    - Implemented unit tests for torque limit behavior and anti-windup in position control.
    - Developed tests for serial protocol encoding/decoding, including C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
    [app.c, bldc.c, bldc.h, config.h, test_limits.c, test_protocol.c]
2026-08-26 Add internal header for BLDC control and calibration
    This commit introduces a new header file `bldc_internal.h` that contains internal state definitions and helper functions shared between the BLDC control loop and motor calibration. Key features include:
    - Definitions for capturing motor measurements and handling encoder values.
    - Struct `SensoredVectorControl` to manage motor parameters, state, and control commands.
    - Inline functions for PWM output and encoder saturation checks.
    - Functions for updating encoder scale and performing motor calibration.
    This file is intended for internal use only and should not be included in public API headers.
2026-08-26 feat(bldc): Update maximum angular acceleration and overcurrent limit, adjust position control deadband
2026-08-27 feat(bldc): Implement brake mode with boundary layer control to prevent chattering
    [bldc.c, config.h]
2026-09-12 fix(bldc): レビュー指摘の防御的ガード不備を修正 (serial満杯検出/Kt除算/Flash端数/speed折り返し)
2026-09-27 feat(bldc): Update UART baud rate to 1 Mbps and adjust DMA settings for improved serial communication
2026-10-09 Refactor BLDC internal header and current sensing modules
    - Simplified comments and improved clarity in bldc_internal.h, focusing on shared internal states and helper functions.
    - Enhanced documentation in current_sense.c and current_sense.h for ADC current sensing initialization and calibration.
    - Updated FOC functions in foc.c and foc.h for better readability and performance, including sin/cos calculations and voltage vector limiting.
    - Removed redundant comments and streamlined explanations throughout the codebase for improved maintainability.
2026-10-09 過電流ラッチの競合で駆動が続く不具合を修正、異常中も状態フレームを通常周期で返し復帰時は古い指令を捨てる、エンコーダ未校正の検出・ウォッチドッグ・回転中のゼロ点校正のやり直しを追加
2026-10-10 fix(bldc): Adjust PID integral gain and update position control parameters for improved stability
    [bldc.c, bldc.h]
2026-10-19 feat(bldc): 校正を作り直し (ISR内で記録、J/Kt・摩擦・電流帯域・補正テーブル、既定値廃止)
    スイッチ校正を「全部成功したときだけ1回でフラッシュに書く」方式にまとめ、
    測定をメインループの HAL_Delay ではなく制御ループ (20kHz/1kHz) の中で
    記録・平均するようにした。旧 J 同定は HAL_Delay(1) が約2ms待つせいで
    加速度を約1/2に読み、J と速度ゲインが約2倍になっていた。
    校正手順 (順序に依存関係がある):
    1. R, L : 強制角0で Vd を直接印加 (PIバイパス)。電圧4点の最小二乗で
    R とデッドタイム V0、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
2026-10-19 補正テーブルを惰性回転で作る方式に変更 (強制転流の偽の14回/周を排除)、%f を全廃して FixFmt 化、過速度保護・速度の揺れ診断・自己試験モードを追加
2026-10-19 レビュー指摘を修正 (未校正時の出力有効化を禁止、ψm を補正テーブル後に測定、受信リセットで送信を切らない、校正の検査強化)
2026-11-09 トルク・制動・停止モードの過速度しきい値を270rad/sに分離
2026-11-09 エンコーダ校正の電流を2倍にし、遅れ判定を電気角基準に変更
2026-11-09 位置PIDゲインを調整しフォーマットを整理
2026-11-09 文書とコメントを整理し、位置制御のテストをファームのゲインに合わせる
